exitrip/DEBAZAROS/ip_repo/edit_myip_v1_0.runs/synth_1/.vivado.begin.rst

<?xml version="1.0"?>
<ProcessHandle Version="1" Minor="0">
    <Process Command="vivado" Owner="aescape" Host="antmicro-debug" Pid="302607" HostCore="20" HostMemory="49028528">
    </Process>
</ProcessHandle>
