exitrip/DEBAZAROS/pcb/3xHDMI/3xHDMI-LCSC-BOM.csv

# | Reference | Value | Qty | SuppliersPartNumber
1 | C3,C7,C9 | 104n | 3 | C14663
2 | C4,C5 | 22p | 2 | C1653
3 | C6,C8 | 106n | 2 | C19702
4 | C10,C11,C12 | 103n | 3 | C57112
5 | D1 | SS34 | 1 | C8678
6 | D4 | LED | 1 | C84263
7 | J1 | HDMI0-OUT | 1 | C111617
9 | J3 | HDMI1-INOUT | 1 | C111617
10 | J4 | HDMI2-INOUT | 1 | C111617
11 | J5 | KH-TYPE-C-16P | 1 | C709357
12 | J6 | POWER_O | 1 | C49257
13 | J7 | DATA3 | 1 | C3012193
14 | J8 | DATA2 | 1 | C3012193
15 | J9 | DATA1 | 1 | C3012193
16 | J10 | SERIAL | 1 | C49257
17 | P1 | Header-Female-2.54_1x8 | 1 | C27438
18 | Q1,Q2,Q3,Q4,Q5,Q6,Q7,Q8,Q9 | AO3400 | 9 | C344010
19 | R1,R4,R7,R8,R9,R11,R15,R20,R23,R28,R31,R37,R38,R40,R43 | 10K | 15 | C25804
20 | R2,R3,R26 | 100K | 3 | C25803
21 | R5,R6,R27 | 27K | 3 | C22967
22 | R10,R12,R14,R16,R17,R21,R22,R24,R25,R29,R30,R32,R33,R39,R41,R42,R44,R45 | 2K2 | 18 | C4190
23 | R13,R18 | 5K1 | 2 | C23186
24 | R19 | 1K | 1 | C21190
25 | R34,R35,R36 | 1M | 3 | C22935
26 | RN1,RN2,RN3,RN4,RN5,RN6 | 49.9R | 6 | C54832
27 | SW1,SW2,SW3,SW4,SW5,SW6 | KEY | 6 | C318938
28 | U1 | CH340G | 1 | C14267
29 | U2 | AMS1117-3.3 | 1 | C347222
30 | X1 | 12MHz | 1 | C14871
