exitrip/DEBAZAROS/pcb/3xHDMI/3xHDMI-openEMS-TopyIn1-simple.FCStd

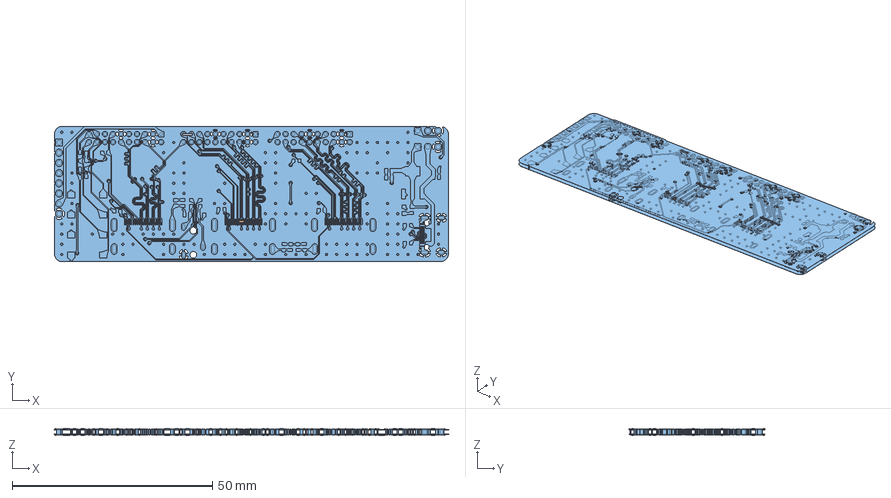
[picture p3: CAD file, 2026-08-24]
pcb/3xHDMI/3xHDMI-openEMS-TopyIn1-simple.FCStd
98.3 x 33.8 x 1.57 mm
portPin
portPout
copper
