exitrip/DEBAZAROS/pcb/3xHDMI/openEMS-sim/fr4_gen_model.stl

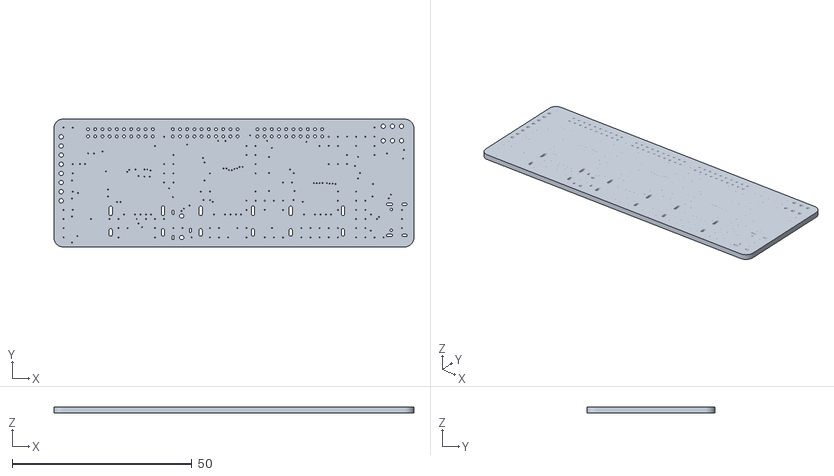
[picture p4: CAD file, 2026-08-24]
pcb/3xHDMI/openEMS-sim/fr4_gen_model.stl
100.0 x 35.5 x 1.59
