exitrip/DEBAZAROS/pcb/mech/enclosure.FCStd

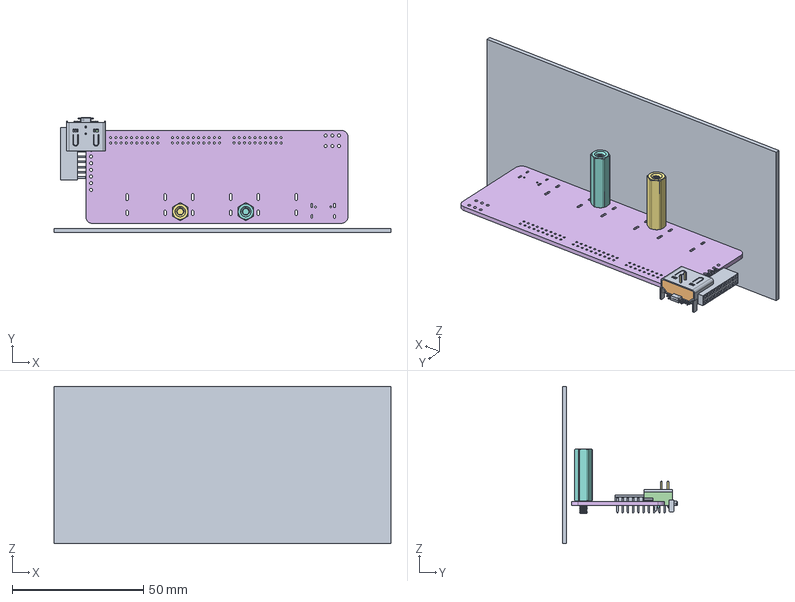
[picture p5: CAD file, 2026-11-03]
pcb/mech/enclosure.FCStd
128.5 x 44.0 x 60.0 mm
Panel
housing
contacts
R_0603_1608Metric
C_0603_1608Metric
R_0603_1608Metric002
R_0603_1608Metric004
PinSocket_2x10_P2.00mm_Horizontal
PinSocket_2x10_P2.00mm_Horizontal002
R_0603_1608Metric006
SOT-223
R_0603_1608Metric008
R_0603_1608Metric010
base
cover
actuator
leads
R_0603_1608Metric012
C_0603_1608Metric002
PinSocket_2x10_P2.00mm_Horizontal004
base001
cover001
actuator001
leads001
C_0603_1608Metric004
R_0603_1608Metric014
housing001
contacts001
R_0603_1608Metric016
R_0603_1608Metric018
housing002
contacts002
base002
cover002
actuator002
leads002
R_0603_1608Metric020
C_0603_1608Metric006
R_0603_1608Metric022
base003
cover003
actuator003
leads003
R_0603_1608Metric024
housing003
contacts003
LED_0603_1608Metric
C_0603_1608Metric008
R_0603_1608Metric026
R_0603_1608Metric028
C_0603_1608Metric010
R_0603_1608Metric030
SOIC-16_3.9x9.9mm_P1.27mm
SOT-23
SOT-226
R_Array_Convex_4x0603
R_0603_1608Metric032
R_0603_1608Metric034
PinHeader_1x02_P254mm_Vertical_SMD_Pin1Left
R_0603_1608Metric036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
