exitrip/DEBAZAROS/pcb/3xHDMI/openEMS-sim/air_gen_model.stl

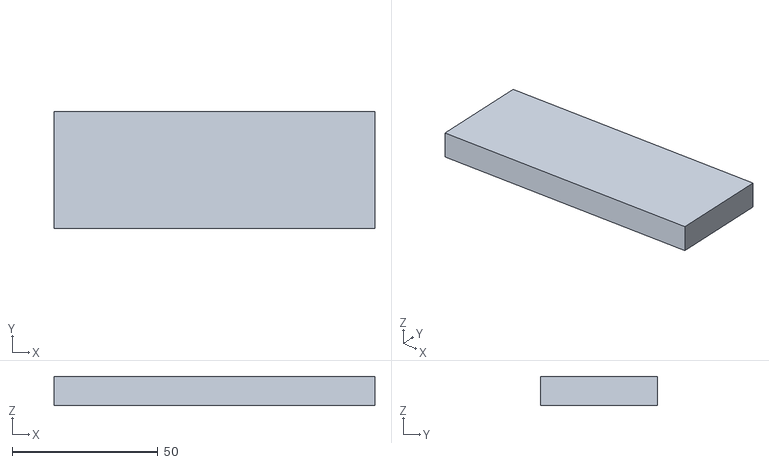
[picture p6: CAD file, 2026-08-24]
pcb/3xHDMI/openEMS-sim/air_gen_model.stl
110.0 x 40.0 x 10.0
