exitrip/DEBAZAROS/pcb/mech/3xHDMI.step

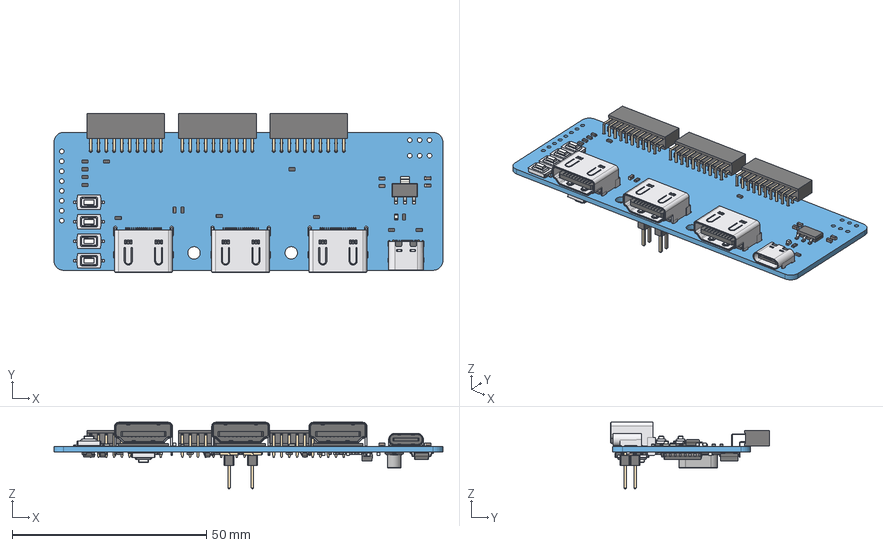
[picture p7: CAD file, 2026-11-01]
pcb/mech/3xHDMI.step
100.0 x 40.8 x 17.1 mm
housing x 4
contacts x 4
R_0603_1608Metric x 45
C_0603_1608Metric x 10
PinSocket_2x10_P2.00mm_Horizontal x 3
SOT-223
base x 6
cover x 6
actuator x 6
leads x 6
LED_0603_1608Metric
SOIC-16_3.9x9.9mm_P1.27mm
SOT-23 x 9
R_Array_Convex_4x0603 x 6
PinHeader_1x02_P254mm_Vertical_SMD_Pin1Left x 2
D_SMA
Crystal_SMD_HC49-SD
3xHDMI-unsaved-export-Y6YrKd_PCB
