exitrip/DEBAZAROS/pcb/mech/93655A428_Male-Female Threaded Hex Standoff.STEP

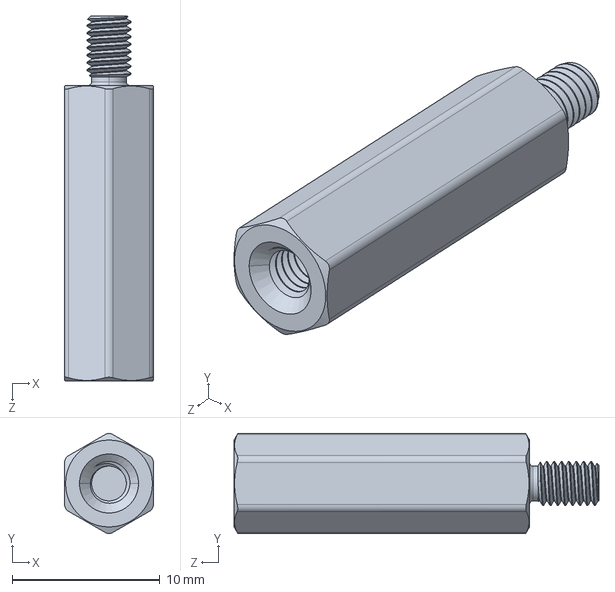
[picture p8: CAD file, 2026-11-01]
pcb/mech/93655A428_Male-Female Threaded Hex Standoff.STEP
6.00 x 6.77 x 24.7 mm
