exitrip/DEBAZAROS/pcb/3xHDMI/3xHDMI.kicad_pcb

## KiCad design pcb/3xHDMI/3xHDMI.kicad_pcb (2026-11-01)

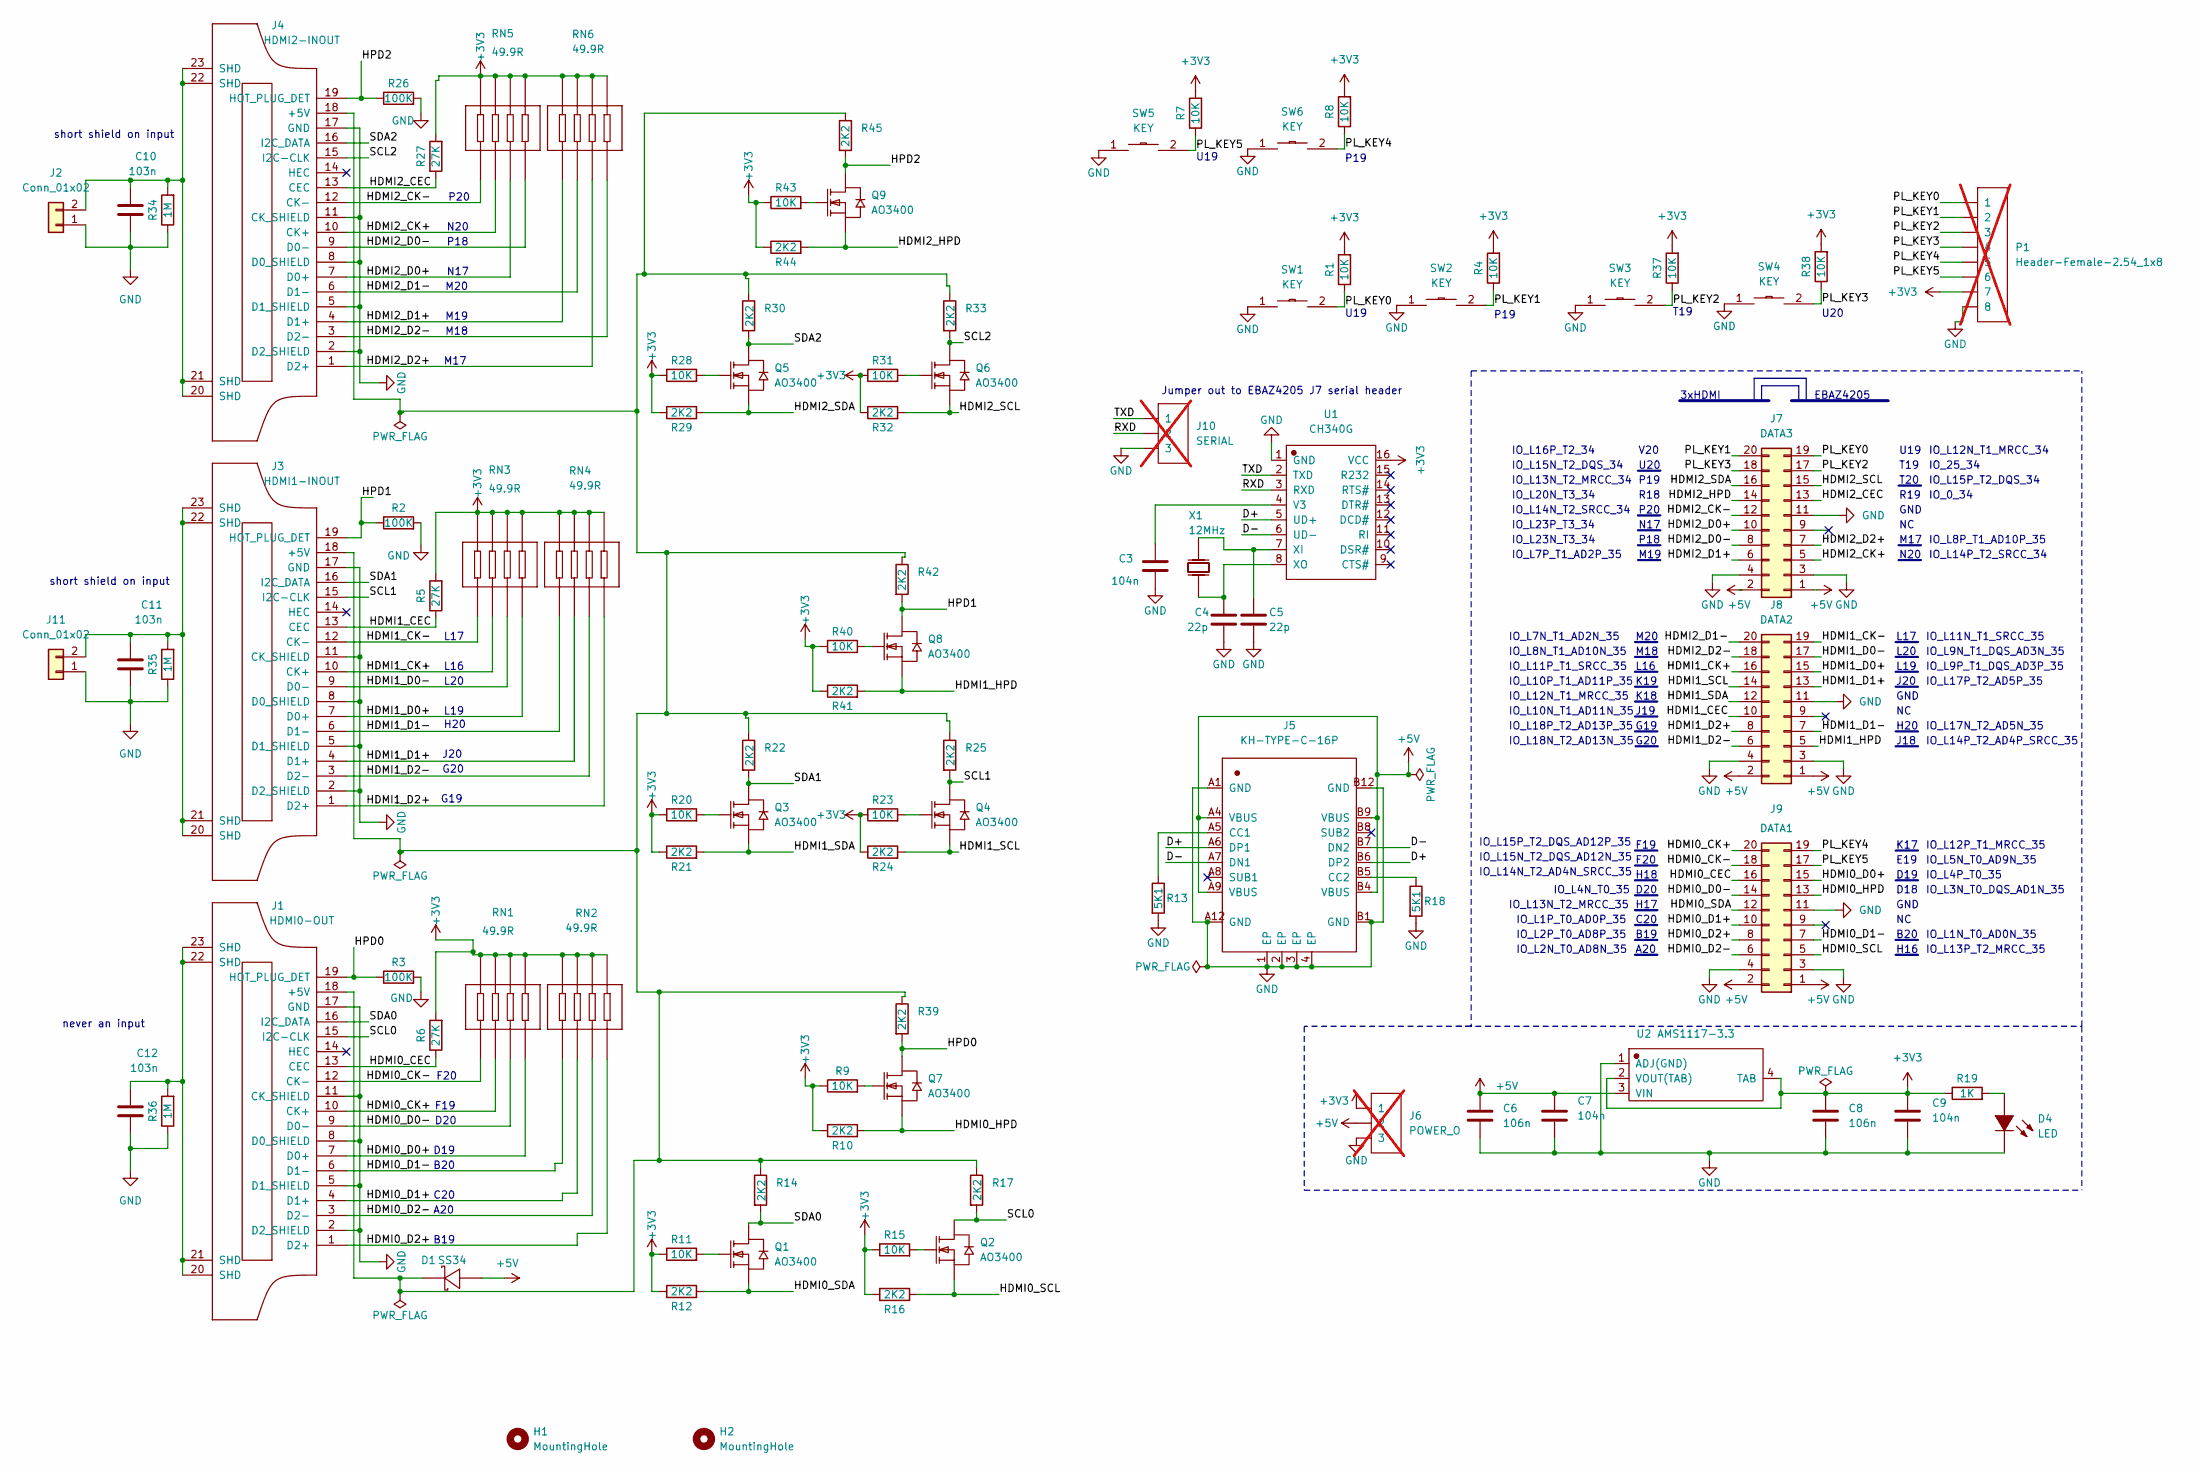
[picture p9: schematic 3xHDMI.kicad_sch]

Parts:
C3, C7, C9: 104n; C0603
C4, C5: 22p; C0603
C6, C8: 106n; C0603
C10, C11, C12: 103n; C0603
D1: SS34; DO-214AC_L4.3-W2.7-LS5.3-RD
D4: LED; LED0603-FD
H1, H2: MountingHole; MountingHole_3.2mm_M3
J1: HDMI0-OUT; HDMI-SMD_HDMI-019S
J2, J11: Conn_01x02; PinHeader_1x02_P2.54mm_Vertical_SMD_Pin1Left
J3: HDMI1-INOUT; HDMI-SMD_HDMI-019S
J4: HDMI2-INOUT; HDMI-SMD_HDMI-019S
J5: KH-TYPE-C-16P; USB-C-SMD_KH-TYPE-C-16P
J6: POWER_O; HDR-TH_3P-P2.54-V-M-1; not fitted
J7: DATA3; EBAZEXT-DAT
J8: DATA2; EBAZEXT-DAT
J9: DATA1; EBAZEXT-DAT
J10: SERIAL; HDR-TH_3P-P2.54-V-M-1; not fitted
P1: Header-Female-2.54_1x8; HDR-TH_8P-P2.54-V-F-1; not fitted
Q1, Q2, Q3, Q4, Q5, Q6, Q7, Q8, Q9: AO3400; SOT-23_L2.9-W1.3-P1.90-LS2.4-BR
R1, R4, R7, R8, R9, R11, R15, R20, R23, R28, R31, R37, R38, R40, R43: 10K; R0603
R2, R3, R26: 100K; R0603
R5, R6, R27: 27K; R0603
R10, R12, R14, R16, R17, R21, R22, R24, R25, R29, R30, R32, R33, R39, R41, R42, R44, R45: 2K2; R0603
R13, R18: 5K1; R0603
R19: 1K; R0603
R34, R35, R36: 1M; R0603
RN1, RN2, RN3, RN4, RN5, RN6: 49.9R; RES-ARRAY-SMD_0603-8P-L3.2-W1.6-BL
SW1, SW2, SW3, SW4, SW5, SW6: KEY; SW-SMD_L6.0-W3.3-LS8.0
U1: CH340G; SOIC-16_L9.9-W3.9-P1.27-LS6.0-BL
U2: AMS1117-3.3; SOT-223-4_L6.5-W3.5-P2.30-LS7.0-BR
X1: 12MHz; HC-49S_L11.4-W4.8

Connections:
+3V3: C8.1, C9.1, J6.1, P1.7, R1.2, R4.2, R5.2, R6.2, R7.2, R8.2, R9.1, R10.1, R11.1, R12.1, R15.1, R16.1, R19.1, R20.1, R21.1, R23.1, R24.1, R27.2, R28.1, R29.1, R31.1, R32.1, R37.2, R38.2, R40.1, R41.1, R43.1, R44.1, RN1.5, RN1.6, RN1.7, RN1.8, RN2.5, RN2.6, RN2.7, RN2.8, RN3.5, RN3.6, RN3.7, RN3.8, RN4.5, RN4.6, RN4.7, RN4.8, RN5.5, RN5.6, RN5.7, RN5.8, RN6.5, RN6.6, RN6.7, RN6.8, U1.16 (VCC), U2.2 (VOUT(TAB)), U2.4 (TAB)
+5V: C6.1, C7.1, D1.2 (A), J5.A4 (VBUS), J5.A9 (VBUS), J5.B4 (VBUS), J5.B9 (VBUS), J6.2, J7.1, J7.2, J8.1, J8.2, J9.1, J9.2, U2.3 (VIN)
/D+: J5.A6 (DP1), J5.B6 (DP2), U1.5 (UD+)
/D-: J5.A7 (DN1), J5.B7 (DN2), U1.6 (UD-)
/HDMI0_CEC: J1.13 (CEC), J9.16, R6.1
/HDMI0_CK+: J1.10 (CK+), J9.20, RN1.3
/HDMI0_CK-: J1.12 (CK-), J9.18, RN1.4
/HDMI0_D0+: J1.7 (D0+), J9.15, RN1.1
/HDMI0_D0-: J1.9 (D0-), J9.14, RN1.2
/HDMI0_D1+: J1.4 (D1+), J9.10, RN2.3
/HDMI0_D1-: J1.6 (D1-), J9.7, RN2.4
/HDMI0_D2+: J1.1 (D2+), J9.8, RN2.1
/HDMI0_D2-: J1.3 (D2-), J9.6, RN2.2
/HDMI0_HPD: J9.13, Q7.2 (S), R10.2
/HDMI0_SCL: J9.5, Q2.2 (S), R16.2
/HDMI0_SDA: J9.12, Q1.2 (S), R12.2
/HDMI1_CEC: J3.13 (CEC), J8.10, R5.1
/HDMI1_CK+: J3.10 (CK+), J8.16, RN3.2
/HDMI1_CK-: J3.12 (CK-), J8.19, RN3.1
/HDMI1_D0+: J3.7 (D0+), J8.15, RN3.4
/HDMI1_D0-: J3.9 (D0-), J8.17, RN3.3
/HDMI1_D1+: J3.4 (D1+), J8.13, RN4.2
/HDMI1_D1-: J3.6 (D1-), J8.7, RN4.1
/HDMI1_D2+: J3.1 (D2+), J8.8, RN4.4
/HDMI1_D2-: J3.3 (D2-), J8.6, RN4.3
/HDMI1_HPD: J8.5, Q8.2 (S), R41.2
/HDMI1_SCL: J8.14, Q4.2 (S), R24.2
/HDMI1_SDA: J8.12, Q3.2 (S), R21.2
/HDMI2_CEC: J4.13 (CEC), J7.13, R27.1
/HDMI2_CK+: J4.10 (CK+), J7.5, RN5.2
/HDMI2_CK-: J4.12 (CK-), J7.12, RN5.1
/HDMI2_D0+: J4.7 (D0+), J7.10, RN5.3
/HDMI2_D0-: J4.9 (D0-), J7.8, RN5.4
/HDMI2_D1+: J4.4 (D1+), J7.6, RN6.1
/HDMI2_D1-: J4.6 (D1-), J8.20, RN6.2
/HDMI2_D2+: J4.1 (D2+), J7.7, RN6.3
/HDMI2_D2-: J4.3 (D2-), J8.18, RN6.4
/HDMI2_HPD: J7.14, Q9.2 (S), R44.2
/HDMI2_SCL: J7.15, Q6.2 (S), R32.2
/HDMI2_SDA: J7.16, Q5.2 (S), R29.2
/HPD0: J1.19 (HOT_PLUG_DET), Q7.3 (D), R3.1, R39.2
/HPD1: J3.19 (HOT_PLUG_DET), Q8.3 (D), R2.1, R42.2
/HPD2: J4.19 (HOT_PLUG_DET), Q9.3 (D), R26.1, R45.2
/PL_KEY0: J7.19, P1.1, R1.1, SW1.2
/PL_KEY1: J7.20, P1.2, R4.1, SW2.2
/PL_KEY2: J7.17, P1.3, R37.1, SW3.2
/PL_KEY3: J7.18, P1.4, R38.1, SW4.2
/PL_KEY4: J9.19, P1.5, R8.1, SW6.2
/PL_KEY5: J9.17, P1.6, R7.1, SW5.2
/RXD: J10.2, U1.3 (RXD)
/SCL0: J1.15 (I2C-CLK), Q2.3 (D), R17.2
/SCL1: J3.15 (I2C-CLK), Q4.3 (D), R25.2
/SCL2: J4.15 (I2C-CLK), Q6.3 (D), R33.2
/SDA0: J1.16 (I2C_DATA), Q1.3 (D), R14.2
/SDA1: J3.16 (I2C_DATA), Q3.3 (D), R22.2
/SDA2: J4.16 (I2C_DATA), Q5.3 (D), R30.2
/TXD: J10.1, U1.2 (TXD)
GND: C3.2, C4.2, C5.2, C6.2, C7.2, C8.2, C9.2, C10.2, C11.2, C12.2, D4.2 (K), J1.2 (D2_SHIELD), J1.5 (D1_SHIELD), J1.8 (D0_SHIELD), J1.11 (CK_SHIELD), J1.17 (GND), J2.1, J3.2 (D2_SHIELD), J3.5 (D1_SHIELD), J3.8 (D0_SHIELD), J3.11 (CK_SHIELD), J3.17 (GND), J4.2 (D2_SHIELD), J4.5 (D1_SHIELD), J4.8 (D0_SHIELD), J4.11 (CK_SHIELD), J4.17 (GND), J5.1 (EP), J5.2 (EP), J5.3 (EP), J5.4 (EP), J5.A1 (GND), J5.A12 (GND), J5.B1 (GND), J5.B12 (GND), J6.3, J7.3, J7.4, J7.11, J8.3, J8.4, J8.11, J9.3, J9.4, J9.11, J10.3, J11.1, P1.8, R2.2, R3.2, R13.2, R18.2, R26.2, R34.1, R35.1, R36.1, SW1.1, SW2.1, SW3.1, SW4.1, SW5.1, SW6.1, U1.1 (GND), U2.1 (ADJ(GND))
unnamed: C12.1, J1.20 (SHD), J1.21 (SHD), J1.22 (SHD), J1.23 (SHD), R36.2
unnamed: D1.1 (K), J1.18 (+5V), J3.18 (+5V), J4.18 (+5V), R14.1, R17.1, R22.1, R25.1, R30.1, R33.1, R39.1, R42.1, R45.1
unnamed: D4.1 (A), R19.2
unnamed: C10.1, J2.2, J4.20 (SHD), J4.21 (SHD), J4.22 (SHD), J4.23 (SHD), R34.2
unnamed: J5.A5 (CC1), R13.1
unnamed: J5.B5 (CC2), R18.1
unnamed: C11.1, J3.20 (SHD), J3.21 (SHD), J3.22 (SHD), J3.23 (SHD), J11.2, R35.2
unnamed: Q1.1 (G), R11.2
unnamed: Q2.1 (G), R15.2
unnamed: Q3.1 (G), R20.2
unnamed: Q4.1 (G), R23.2
unnamed: Q5.1 (G), R28.2
unnamed: Q6.1 (G), R31.2
unnamed: Q7.1 (G), R9.2
unnamed: Q8.1 (G), R40.2
unnamed: Q9.1 (G), R43.2
unnamed: C3.1, U1.4 (V3)
unnamed: C5.1, U1.7 (XI), X1.1 (OSC1)
unnamed: C4.1, U1.8 (XO), X1.2 (OSC2)

Notes on the sheet:
IO_L3N_T0_DQS_AD1N_35
EBAZ4205
B19
M20
G20
L19
C20
IO_L11N_T1_SRCC_35
P19
GND
IO_L10P_T1_AD11P_35
IO_L5N_T0_AD9N_35
F20
IO_L9N_T1_DQS_AD3N_35
J18
K19
IO_L13P_T2_MRCC_35
R18
IO_L13N_T2_MRCC_35
A20
F19
IO_L9P_T1_DQS_AD3P_35
N20
IO_L1N_T0_AD0N_35
N17
L20
P20
G19
IO_L15P_T2_DQS_AD12P_35
D20
IO_L2P_T0_AD8P_35
IO_25_34
H20
short shield on input
IO_L23N_T3_34
3xHDMI
IO_L14N_T2_AD4N_SRCC_35
M18
H17
never an input
IO_L4P_T0_35
P18
U20
T19
IO_L7N_T1_AD2N_35
R19
IO_L14P_T2_AD4P_SRCC_35
IO_L11P_T1_SRCC_35
IO_L18P_T2_AD13P_35
IO_L15P_T2_DQS_34
IO_L20N_T3_34
J19
L16
IO_L8P_T1_AD10P_35
H16
IO_L1P_T0_AD0P_35
E19
IO_L12N_T1_MRCC_35
IO_L12N_T1_MRCC_34
IO_L4N_T0_35
IO_L12P_T1_MRCC_35
IO_L7P_T1_AD2P_35
IO_L15N_T2_DQS_AD12N_35
IO_L8N_T1_AD10N_35
U19
M17
B20
D18
IO_L16P_T2_34
IO_L2N_T0_AD8N_35
H18
IO_0_34
D19
IO_L14P_T2_SRCC_34
IO_L13N_T2_MRCC_34
IO_L10N_T1_AD11N_35
T20
IO_L18N_T2_AD13N_35
IO_L17N_T2_AD5N_35
M19
IO_L17P_T2_AD5P_35
IO_L15N_T2_DQS_34
Jumper out to EBAZ4205 J7 serial header
L17
J20
K18
IO_L23P_T3_34
V20
IO_L14N_T2_SRCC_34
K17

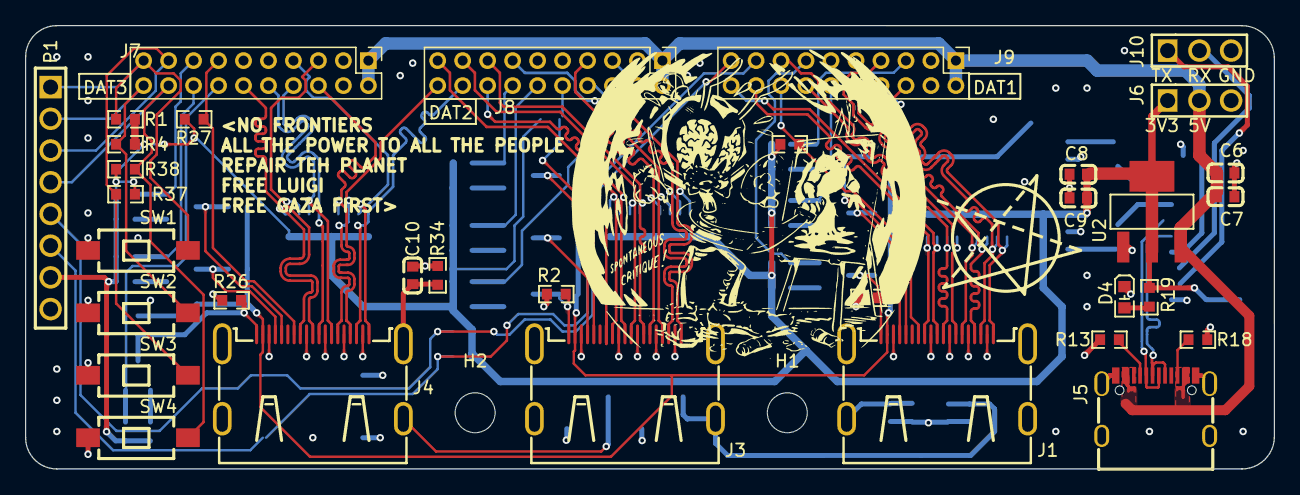
[picture p10: board 3xHDMI.kicad_pcb from above]

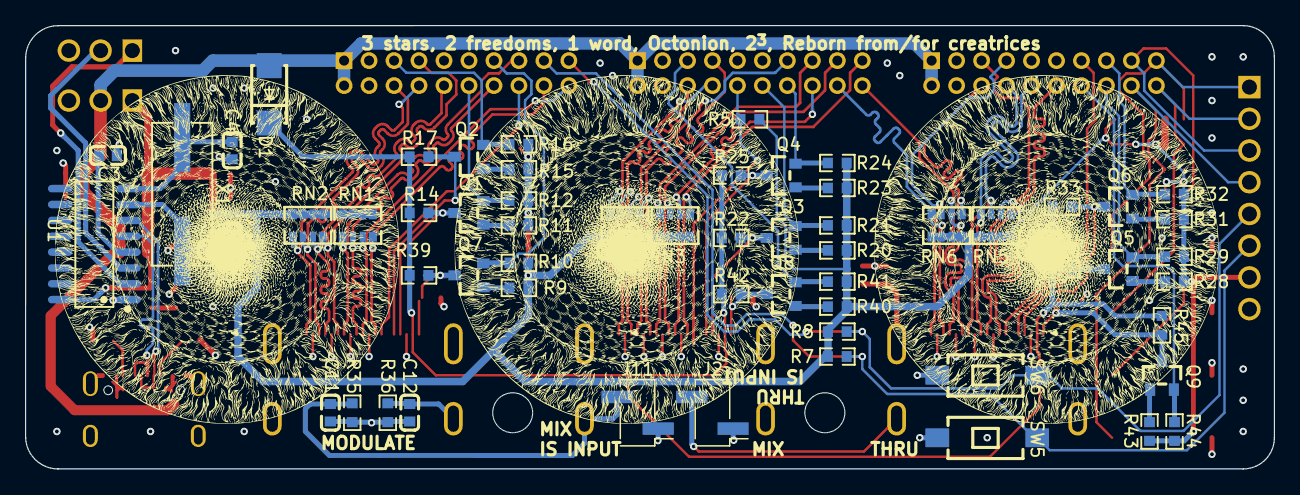
[picture p11: board 3xHDMI.kicad_pcb from below]

Board: 4 copper layers, 100.0 x 35.5 mm, 95 parts (59 on the bottom side), 77 nets.
