exitrip/DEBAZAROS/hw/xdc/ebaz4205.xdc

##
## @file        ebaz4205.xdc
## @brief       Xilinx Design Constraints for EBAZ4205
## @author      Keitetsu
## @date        2021/03/21
## @copyright   Copyright (c) 2021 Keitetsu
## @par         License
##              This software is released under the MIT License.
##

# Clock for Ethernet Transceiver
set_property IOSTANDARD LVCMOS33 [get_ports CLK25M]
set_property PACKAGE_PIN U18 [get_ports CLK25M]

# Ethernet Transceiver
set_property IOSTANDARD LVCMOS33 [get_ports ENET0_GMII_RX_CLK_0]
set_property IOSTANDARD LVCMOS33 [get_ports ENET0_GMII_TX_CLK_0]
set_property PACKAGE_PIN U14 [get_ports ENET0_GMII_RX_CLK_0]
set_property PACKAGE_PIN U15 [get_ports ENET0_GMII_TX_CLK_0]

#[Place 30-876] Port 'ENET0_GMII_TX_CLK_0'  is assigned to PACKAGE_PIN 'U15'  which can only be used as the N side of a differential clock input.
#Please use the following constraint(s) to pass this DRC check:
set_property CLOCK_DEDICATED_ROUTE FALSE [get_nets ENET0_GMII_TX_CLK_0_IBUF]

set_property IOSTANDARD LVCMOS33 [get_ports {enet0_gmii_rxd[3]}]
set_property IOSTANDARD LVCMOS33 [get_ports {enet0_gmii_rxd[2]}]
set_property IOSTANDARD LVCMOS33 [get_ports {enet0_gmii_rxd[1]}]
set_property IOSTANDARD LVCMOS33 [get_ports {enet0_gmii_rxd[0]}]
set_property IOSTANDARD LVCMOS33 [get_ports {ENET0_GMII_TX_EN_0[0]}]
set_property IOSTANDARD LVCMOS33 [get_ports {enet0_gmii_txd[3]}]
set_property IOSTANDARD LVCMOS33 [get_ports {enet0_gmii_txd[2]}]
set_property IOSTANDARD LVCMOS33 [get_ports {enet0_gmii_txd[1]}]
set_property IOSTANDARD LVCMOS33 [get_ports {enet0_gmii_txd[0]}]
set_property IOSTANDARD LVCMOS33 [get_ports ENET0_GMII_RX_DV_0]
set_property IOSTANDARD LVCMOS33 [get_ports MDIO_ETHERNET_0_0_mdc]
set_property IOSTANDARD LVCMOS33 [get_ports MDIO_ETHERNET_0_0_mdio_io]
set_property PACKAGE_PIN Y17 [get_ports {enet0_gmii_rxd[3]}]
set_property PACKAGE_PIN V17 [get_ports {enet0_gmii_rxd[2]}]
set_property PACKAGE_PIN V16 [get_ports {enet0_gmii_rxd[1]}]
set_property PACKAGE_PIN Y16 [get_ports {enet0_gmii_rxd[0]}]
set_property PACKAGE_PIN W19 [get_ports {ENET0_GMII_TX_EN_0[0]}]
set_property PACKAGE_PIN Y19 [get_ports {enet0_gmii_txd[3]}]
set_property PACKAGE_PIN V18 [get_ports {enet0_gmii_txd[2]}]
set_property PACKAGE_PIN Y18 [get_ports {enet0_gmii_txd[1]}]
set_property PACKAGE_PIN W18 [get_ports {enet0_gmii_txd[0]}]
set_property PACKAGE_PIN W16 [get_ports ENET0_GMII_RX_DV_0]
set_property PACKAGE_PIN W15 [get_ports MDIO_ETHERNET_0_0_mdc]
set_property PACKAGE_PIN Y14 [get_ports MDIO_ETHERNET_0_0_mdio_io]

# Green LED
set_property IOSTANDARD LVCMOS33 [get_ports {LED_GREEN[0]}]
set_property PACKAGE_PIN W13 [get_ports {LED_GREEN[0]}]

# Red LED
set_property IOSTANDARD LVCMOS33 [get_ports {LED_RED[0]}]
set_property PACKAGE_PIN W14 [get_ports {LED_RED[0]}]

#J3 4-pin fan connector: 12 V optocoupler level shift, NOT isolated (GND3 = GND via L36); ROADMAP.md section 11
set_property -dict {PACKAGE_PIN U12 IOSTANDARD LVCMOS33} [get_ports {J3P4_OUTPUT}]
set_property -dict {PACKAGE_PIN V13 IOSTANDARD LVCMOS33} [get_ports {J3P3_INPUT}]

#J5 4-pin fan connector: same circuit as J3
set_property -dict {PACKAGE_PIN V12 IOSTANDARD LVCMOS33} [get_ports {J5P4_OUTPUT}]
set_property -dict {PACKAGE_PIN V15 IOSTANDARD LVCMOS33} [get_ports {J5P3_INPUT}]

##MOD for LCDHaving extBoard
set_property -dict {PACKAGE_PIN A20 IOSTANDARD TMDS_33} [get_ports {TMDS_Data_n_0[2]}]
set_property -dict {PACKAGE_PIN F19 IOSTANDARD TMDS_33} [get_ports TMDS_Clk_p_0]
set_property -dict {PACKAGE_PIN B19 IOSTANDARD TMDS_33} [get_ports {TMDS_Data_p_0[2]}]
set_property -dict {PACKAGE_PIN B20 IOSTANDARD TMDS_33} [get_ports {TMDS_Data_n_0[1]}]
set_property -dict {PACKAGE_PIN C20 IOSTANDARD TMDS_33} [get_ports {TMDS_Data_p_0[1]}]
set_property -dict {PACKAGE_PIN F20 IOSTANDARD TMDS_33} [get_ports TMDS_Clk_n_0]
set_property -dict {PACKAGE_PIN D20 IOSTANDARD TMDS_33} [get_ports {TMDS_Data_n_0[0]}]
set_property -dict {PACKAGE_PIN D18 IOSTANDARD LVCMOS33} [get_ports {HDMI_HPD[0]}]
set_property -dict {PACKAGE_PIN H18 IOSTANDARD LVCMOS33} [get_ports HDMI_CEC_0]
set_property -dict {PACKAGE_PIN D19 IOSTANDARD TMDS_33} [get_ports {TMDS_Data_p_0[0]}]
#set_property -dict { PACKAGE_PIN H16   IOSTANDARD LVCMOS33 } [get_ports { HDMI_SCL_0 }];
#set_property -dict { PACKAGE_PIN H17   IOSTANDARD LVCMOS33 } [get_ports { HDMI_SDA_0 }];
set_property -dict { PACKAGE_PIN K17   IOSTANDARD LVCMOS33 } [get_ports { AUDIO_L }];
set_property -dict { PACKAGE_PIN E19   IOSTANDARD LVCMOS33 } [get_ports { AUDIO_R }];

##DATA2
#HDMI1
set_property -dict {PACKAGE_PIN L16 IOSTANDARD TMDS_33} [get_ports TMDS_Clk_p_1]
set_property -dict {PACKAGE_PIN L17 IOSTANDARD TMDS_33} [get_ports TMDS_Clk_n_1]
set_property -dict {PACKAGE_PIN G19 IOSTANDARD TMDS_33} [get_ports {TMDS_Data_p_1[2]}]
set_property -dict {PACKAGE_PIN G20 IOSTANDARD TMDS_33} [get_ports {TMDS_Data_n_1[2]}]
set_property -dict {PACKAGE_PIN J20 IOSTANDARD TMDS_33} [get_ports {TMDS_Data_p_1[1]}]
set_property -dict {PACKAGE_PIN H20 IOSTANDARD TMDS_33} [get_ports {TMDS_Data_n_1[1]}]
set_property -dict {PACKAGE_PIN L19 IOSTANDARD TMDS_33} [get_ports {TMDS_Data_p_1[0]}]
set_property -dict {PACKAGE_PIN L20 IOSTANDARD TMDS_33} [get_ports {TMDS_Data_n_1[0]}]
set_property -dict {PACKAGE_PIN J18 IOSTANDARD LVCMOS33} [get_ports {HDMI_HPD[1]}]
set_property -dict {PACKAGE_PIN J19 IOSTANDARD LVCMOS33} [get_ports {HDMI_CEC_1[0]}]
#set_property -dict { PACKAGE_PIN K19   IOSTANDARD LVCMOS33 } [get_ports { HDMI_SCL_1 }];
#set_property -dict { PACKAGE_PIN K18   IOSTANDARD LVCMOS33 } [get_ports { HDMI_SDA_1 }];

#HDMI2
#set_property -dict { PACKAGE_PIN M18   IOSTANDARD TMDS_33 } [get_ports {TMDS_Data_n_2[2]}];
#set_property -dict { PACKAGE_PIN M20   IOSTANDARD TMDS_33 } [get_ports {TMDS_Data_n_2[1]}];

#DATA3
#HDMI2
set_property -dict {PACKAGE_PIN N20 IOSTANDARD TMDS_33} [get_ports TMDS_Clk_p_2]
set_property -dict {PACKAGE_PIN P20 IOSTANDARD TMDS_33} [get_ports TMDS_Clk_n_2]
set_property -dict {PACKAGE_PIN M17 IOSTANDARD TMDS_33} [get_ports {TMDS_Data_p_2[2]}]
set_property -dict {PACKAGE_PIN M18 IOSTANDARD TMDS_33} [get_ports {TMDS_Data_n_2[2]}];
set_property -dict {PACKAGE_PIN M19 IOSTANDARD TMDS_33} [get_ports {TMDS_Data_p_2[1]}]
set_property -dict {PACKAGE_PIN M20 IOSTANDARD TMDS_33} [get_ports {TMDS_Data_n_2[1]}];
set_property -dict {PACKAGE_PIN N17 IOSTANDARD TMDS_33} [get_ports {TMDS_Data_p_2[0]}]
set_property -dict {PACKAGE_PIN P18 IOSTANDARD TMDS_33} [get_ports {TMDS_Data_n_2[0]}]
set_property -dict {PACKAGE_PIN R18 IOSTANDARD LVCMOS33} [get_ports HDMI_HPD_2]
#set_property -dict { PACKAGE_PIN R19   IOSTANDARD LVCMOS33 } [get_ports { HDMI_CEC_2[0] }];
set_property -dict {PACKAGE_PIN T20 IOSTANDARD LVCMOS33} [get_ports DDC_2_scl_io]
set_property -dict {PACKAGE_PIN P19 IOSTANDARD LVCMOS33} [get_ports DDC_2_sda_io]
##buttons
set_property -dict { PACKAGE_PIN U19   IOSTANDARD LVCMOS33 } [get_ports { PL_KEY[0] }];
set_property -dict { PACKAGE_PIN V20   IOSTANDARD LVCMOS33 } [get_ports { PL_KEY[1] }];
set_property -dict { PACKAGE_PIN T19   IOSTANDARD LVCMOS33 } [get_ports { PL_KEY[2] }];
set_property -dict { PACKAGE_PIN U20   IOSTANDARD LVCMOS33 } [get_ports { PL_KEY[3] }];

#720p60Hz max input
create_clock -period 13.468 -waveform {0.000 6.734} [get_ports TMDS_Clk_p_2]
#100T
create_clock -period 40.000 -name enet0_rx_clk [get_ports ENET0_GMII_RX_CLK_0]
create_clock -period 40.000 -name enet0_tx_clk [get_ports ENET0_GMII_TX_CLK_0]

#create_pblock pblock_AD9851
#add_cells_to_pblock [get_pblocks pblock_AD9851] [get_cells -quiet [list ebaz4205_i/AD9851]]
#resize_pblock [get_pblocks pblock_AD9851] -add {CLOCKREGION_X1Y0:CLOCKREGION_X1Y0}

create_pblock pblock_ebaz4205_i
add_cells_to_pblock [get_pblocks pblock_ebaz4205_i] [get_cells -quiet [list ebaz4205_i]]
resize_pblock [get_pblocks pblock_ebaz4205_i] -add {SLR0}

## HDMI audio (hw/rtl/hdmi_tx, 2026-10-26): clock-domain crossings by design.
## (gray pointers: Vivado merges the gray MSB into the binary MSB register, so
## the -from lists name both wg/wp and rg/rp)
## hdmi_rx: HDMI_2 input clock -> output pixel clock (gray-pointer FIFO),
## FCLK0 -> input clock (rx_ctrl synchronizers); hdmi_audio_regs samples the
## receiver's hold registers after a toggle handshake.
set_max_delay -datapath_only 5.0 -from [get_cells -quiet -hier -filter {NAME =~ *hdmi_rx_0/inst/wg_reg[*] || NAME =~ *hdmi_rx_0/inst/wp_reg[*]}] -to [get_cells -quiet -hier -filter {NAME =~ *hdmi_rx_0/inst/wg_s1_reg[*]}]
set_max_delay -datapath_only 5.0 -from [get_cells -quiet -hier -filter {NAME =~ *hdmi_rx_0/inst/rg_reg[*] || NAME =~ *hdmi_rx_0/inst/rp_reg[*]}] -to [get_cells -quiet -hier -filter {NAME =~ *hdmi_rx_0/inst/rg_s1_reg[*]}]
set_max_delay -datapath_only 10.0 -from [get_cells -quiet -hier -filter {NAME =~ *hdmi_rx_0/inst/fifo_reg*}] -to [get_cells -quiet -hier -filter {NAME =~ *hdmi_rx_0/inst/tx_aud_*_reg[*]}]
set_false_path -to [get_cells -quiet -hier -filter {NAME =~ *hdmi_rx_0/inst/clr_s_reg[0] || NAME =~ *hdmi_rx_0/inst/loop_s_reg[0]}]
set_false_path -to [get_cells -quiet -hier -filter {NAME =~ *hdmi_audio_regs_0/inst/pub_sync_reg[0]}]
set_max_delay -datapath_only 10.0 -from [get_cells -quiet -hier -filter {NAME =~ *hdmi_rx_0/inst/rx_*_reg*}] -to [get_cells -quiet -hier -filter {NAME =~ *hdmi_audio_regs_0/inst/*}]

## pl_io (hw/rtl/pl_io, 2026-10-27): two dz_async_fifo (HDMI_2 clock -> FCLK0
## for I2S out, FCLK0 -> HDMI_1 pixel clock for I2S in) + synchronizers
set_max_delay -datapath_only 5.0 -from [get_cells -quiet -hier -filter {NAME =~ *pl_io_0/* && (NAME =~ */wg_reg[*] || NAME =~ */wp_reg[*])}] -to [get_cells -quiet -hier -filter {NAME =~ *pl_io_0/* && NAME =~ */wg_s1_reg[*]}]
set_max_delay -datapath_only 5.0 -from [get_cells -quiet -hier -filter {NAME =~ *pl_io_0/* && (NAME =~ */rg_reg[*] || NAME =~ */rp_reg[*])}] -to [get_cells -quiet -hier -filter {NAME =~ *pl_io_0/* && NAME =~ */rg_s1_reg[*]}]
set_max_delay -datapath_only 10.0 -from [get_cells -quiet -hier -filter {NAME =~ *pl_io_0/* && NAME =~ */mem_reg*}]
set_false_path -to [get_cells -quiet -hier -filter {NAME =~ *pl_io_0/* && (NAME =~ */txsrc_s_reg[0] || NAME =~ */rxsrc_s_reg[0] || NAME =~ */in_s1_reg[*] || NAME =~ */din_s_reg[0])}]
## Linux PCM (2026-10-27): capture BRAM FIFO (HDMI_2 clock -> FCLK0, covered by
## the wg/wp, rg/rp and mem_reg lines above); one word per 48 kHz frame FCLK0 ->
## pixel clock (w0/w1 hold registers, stable for 20 us, toggle t0/t1).
## Vivado can put w0/w1 into the output register of the pf0/pf1 BRAM (build
## ev: "w0_reg/i_"), so the -from list also names those BRAMs.
set_false_path -to [get_cells -quiet -hier -filter {NAME =~ *pl_io_0/* && (NAME =~ */t0_s_reg[0] || NAME =~ */t1_s_reg[0] || NAME =~ */caprun_s_reg[0] || NAME =~ */pcmsel_s_reg[0] || NAME =~ */pcmsel0_s_reg[0])}]
set_max_delay -datapath_only 10.0 -from [get_cells -quiet -hier -filter {NAME =~ *pl_io_0/* && (NAME =~ */w0_reg[*] || NAME =~ */w1_reg[*] || NAME =~ */pf0/mem_reg* || NAME =~ */pf1/mem_reg*)}]
## events (hdmi_audio_regs page 1, 2026-10-27): vsync (pixel clock) and the
## fan pin 3 inputs into 2-FF synchronizers
set_false_path -to [get_cells -quiet -hier -filter {NAME =~ *hdmi_audio_regs_0/inst/ev_s1_reg[*]}]
## dz_regs bank 0 input (2026-10-29): gpio_in comes from several clocks (HDMI_2
## capture status, fid on FCLK2, user I/O pins) into a 2-FF synchronizer
set_false_path -to [get_cells -quiet -hier -filter {NAME =~ *dz_regs_0/inst/in_s1_reg[*]}]


## ---- output pixel clock (2026-10-28) ---------------------------------------
## axi_dynclk's MMCM is set at run time through the DRP (hdmi2 dynclk.c), so
## Vivado only sees the power-up setting: 500 MHz serial / 100 MHz pixel
## (10 ns). Timed for 108 MHz (1280x1024@60, 1280x960@60): serial 540 MHz =
## 100 MHz x 27 / 5, pixel = serial / 5 (BUFR) = 108 MHz = 9.259 ns.
## 1080p60 (148.5 MHz) stays selectable in hdmi2 but is NOT timed: its serial
## clock (742.5 MHz) is over the OSERDES limit of this speed grade (600 MHz),
## and its DDR load starves the displays (CLAUDE.md). It may glitch.
## (Build p148 timed 148.5 MHz: it could not close, and the placement spread.)
create_generated_clock -name dynclk_ser -source [get_pins ebaz4205_i/axi_dynclk_0/U0/Inst_mmcme2_drp/mmcm_adv_inst/CLKIN1] -multiply_by 27 -divide_by 5 [get_pins ebaz4205_i/axi_dynclk_0/U0/Inst_mmcme2_drp/mmcm_adv_inst/CLKOUT0]
## Global pixel clock (2026-11-02, ROADMAP.md task 20): MMCM CLKOUT1 (divide
## = 5 x CLKOUT0's) on a BUFG = PXL_CLK_O for all fabric logic, 108 MHz =
## 100 MHz x 27 / 25. The BUFR / 5 of the BUFIO serial clock (dynclk_ser /
## 5, derived by Vivado) now drives only the OSERDES CLKDIV; its phase
## against dynclk_pxl is one of 5 (the BUFR divider start): the TMDS words
## cross in hdmi_tx_cdc.v (gray pointers, LUTRAM), so the paths from
## dynclk_pxl to the BUFR clock are a CDC: datapath-only, under one period.
create_generated_clock -name dynclk_pxl -source [get_pins ebaz4205_i/axi_dynclk_0/U0/Inst_mmcme2_drp/mmcm_adv_inst/CLKIN1] -multiply_by 27 -divide_by 25 [get_pins ebaz4205_i/axi_dynclk_0/U0/Inst_mmcme2_drp/mmcm_adv_inst/CLKOUT1]
set dynclk_div [get_clocks -of_objects [get_pins -hier -filter {NAME =~ *axi_dynclk_0/U0/*BUFR_inst/O}]]
set_max_delay -datapath_only -from [get_clocks dynclk_pxl] -to $dynclk_div 9.0
set_max_delay -datapath_only -from $dynclk_div -to [get_clocks dynclk_pxl] 9.0
## The MMCM runs from FCLK0, but at run-time ratios FCLK0 and the pixel clock
## have no fixed phase: every crossing is a designed CDC or a quasi-static
## register (GPIO gains, mixer and VTC settings), and the HDMI_0 DDS quotient
## (FCLK0) into the mixer is a known untimed crossing (value glitches only).
set_clock_groups -asynchronous -group [get_clocks clk_fpga_0] -group [get_clocks -include_generated_clocks {dynclk_ser dynclk_pxl}]
## Mixer mode 1 and the colour matrix (coreRevision 26, 2026-11-02): systolic
## DSP48 MACs with their own registers (possible with the global pixel
## clock), timed for the 108 MHz above like everything else. (Until revision
## 25 mode 1 was combinational, ~17 ns, and false-pathed here.)

## fsync_gen (2026-10-28): VTC vsync (pixel clock) into a 2-FF synchronizer
## in FCLK2 (display VDMA frame sync)
set_false_path -to [get_cells -quiet -hier -filter {NAME =~ *fsync_gen_0/inst/vs_s_reg[0]}]
