exitrip/DEBAZAROS/hw/rtl/hdmi_tx/hdmi_tx.v

// hdmi_tx.v - DVI/HDMI transmitter with audio, a replacement for Digilent
// rgb2dvi 1.4 as this design uses it (kGenerateSerialClk = false,
// kRstActiveHigh = false, no lane swaps). BD module reference.
//
// ctrl = 0: DVI. The TMDS output is the same as rgb2dvi's (same encoder, same
//   channel mapping, same serializer); only the latency is LOOK + 3 clocks longer
//   (sync and data together, so the picture does not move).
// ctrl[0] = 1: HDMI. Data islands in the horizontal blanking of every line:
//   the AVI InfoFrame (every field), and with ctrl[1] audio in ONE format,
//   48 kHz 2-ch 16-bit L-PCM: Audio Clock Regeneration, Audio Sample packets
//   and the Audio InfoFrame. The island position comes from the incoming timing (VTC), so
//   any video mode works: the block measures the line length and the active
//   width, and a LOOK-pixel delay line finds the start of each active line
//   for the video preamble and guard band.
//
// ctrl bits (quasi-static, any clock):
//   [0]    HDMI mode (0 = DVI)
//   [1]    audio packets
//   [2]    test tone: 1 kHz square, -24 dBFS, on the internal sample clock
//   [9:8]  AVI VIC: 0 = 4 (720p60), 1 = 34 (1080p30), 2 = 16 (1080p60), 3 = none
//   [14:12] sync delay: DE, HSYNC and VSYNC N pixel clocks later (0..7). The
//          effects stages register the pixel data after v_axi4s_vid_out,
//          while the syncs come straight from it: without this the picture
//          is N px right of DE (the first N columns = blanking data, the last
//          N source columns lost). 2026-11-01, by eye on the board: HDMI_1
//          N = 5 (3 counted in the BD: colorGainFeedback1 + c_addsub_1/2;
//          the rest not traced), HDMI_0 no visible change at any N (0).
// fs_inc: internal 48 kHz sample clock, fs = fs_inc * f_pixel / 2^32 (0 = off;
//   720p60: 74.25 MHz -> fs_inc = 2776544).
// aud_l/aud_r/aud_valid: external samples, one strobe per stereo sample, in
//   the PixelClk domain (ignored while the test tone is on).
//
// Constant packets: hdmi_tx_rom.v, generated by gen_rom.py.
// Data islands, packets, ECC: ported from hdl-util/hdmi (c) 2019 Sameer Puri,
// MIT licence (LICENSE-hdl-util-MIT). Video encoder and serializer: same
// structure as Digilent rgb2dvi.
`timescale 1ns / 1ps
module hdmi_tx #(
    parameter LOOK = 10,           // >= 10: video preamble (8) + guard (2)
    // 2026-11-02 (ROADMAP.md task 20): 1 (default) = SerdesDivClk is the
    // BUFR / 5 of the BUFIO serial clock while PixelClk is the global BUFG
    // clock: the TMDS words cross in a FIFO (hdmi_tx_cdc.v). 0 = SerdesDivClk
    // has PixelClk's phase (axi_dynclk kSerialBufg true: BUFG + BUFG, or the
    // old design with one BUFR pixel clock): direct.
    parameter CDC_FIFO = 1
) (
    output wire       TMDS_Clk_p,
    output wire       TMDS_Clk_n,
    output wire [2:0] TMDS_Data_p,
    output wire [2:0] TMDS_Data_n,
    input  wire       aRst_n,
    input  wire [23:0] vid_pData,  // [23:16] R (ch 2), [15:8] B (ch 0), [7:0] G (ch 1)
    input  wire       vid_pVDE,
    input  wire       vid_pHSync,
    input  wire       vid_pVSync,
    input  wire       PixelClk,
    input  wire       SerialClk,
    input  wire       SerdesDivClk,  // the OSERDES CLKDIV (axi_dynclk PXL_CLK_DIV_O)
    input  wire [31:0] ctrl,
    input  wire [31:0] fs_inc,
    input  wire [15:0] aud_l,
    input  wire [15:0] aud_r,
    input  wire       aud_valid
);
    // ---- reset: asynchronous assert, synchronous release (as rgb2dvi) -----
    (* ASYNC_REG = "TRUE" *) reg [1:0] rst_sync = 2'b11;
    always @(posedge PixelClk or negedge aRst_n)
        if (!aRst_n)
            rst_sync <= 2'b11;
        else
            rst_sync <= {rst_sync[0], 1'b0};
    wire rst = rst_sync[1];

    reg [31:0] ctrl_q = 0;
    always @(posedge PixelClk) ctrl_q <= ctrl;
    wire       hdmi_en  = ctrl_q[0];
    wire       audio_en = ctrl_q[0] & ctrl_q[1];
    wire       tone_en  = ctrl_q[2];
    wire [1:0] avi_sel  = ctrl_q[9:8];
    wire [2:0] sync_dly = ctrl_q[14:12];

    // ---- sync delay (ctrl[14:12]): {DE, VSYNC, HSYNC} to the data latency ----
    reg  [2:0] sdl [0:6];
    integer j;
    always @(posedge PixelClk) begin
        sdl[0] <= {vid_pVDE, vid_pVSync, vid_pHSync};
        for (j = 1; j < 7; j = j + 1)
            sdl[j] <= sdl[j-1];
    end
    wire [2:0] sync_in = (sync_dly == 3'd0) ? {vid_pVDE, vid_pVSync, vid_pHSync} : sdl[sync_dly - 3'd1];
    wire       de_in   = sync_in[2];

    // ---- look-ahead delay line (SRLs) --------------------------------------
    reg [26:0] dly [0:LOOK-1];
    integer i;
    always @(posedge PixelClk) begin
        dly[0] <= {sync_in, vid_pData};
        for (i = 1; i < LOOK; i = i + 1)
            dly[i] <= dly[i-1];
    end
    wire [26:0] d = dly[LOOK-1];
    wire        de_d = d[26], vs_d = d[25], hs_d = d[24];
    wire [23:0] rgb_d = d[23:0];

    // clocks until the delayed DE rises (LOOK when the undelayed DE rises now)
    reg de_u_q = 0;
    reg [4:0] vcnt = 0;
    always @(posedge PixelClk) de_u_q <= de_in;
    wire rise_u = de_in & ~de_u_q;
    wire [4:0] kk = rise_u ? LOOK[4:0] : vcnt;
    always @(posedge PixelClk) vcnt <= (kk != 0) ? kk - 5'd1 : 5'd0;
    wire vid_pre_0   = hdmi_en && !de_d && kk >= 5'd3 && kk <= 5'd10;
    wire vid_guard_0 = hdmi_en && !de_d && (kk == 5'd1 || kk == 5'd2);

    // ---- line measurement on the delayed stream ----------------------------
    reg        de_d_q = 0;
    // lc: clocks since the last HSYNC rising edge (line length measurement:
    //     HSYNC is on every line, also in the vertical blanking; either sync
    //     polarity gives the same period)
    // hc: position in the line from the DE rise; wraps at line_len, so it
    //     also runs through the lines of the vertical blanking
    reg [12:0] lc = 0, hc = 0, line_len = 0, act_w = 0, llm1 = 0;
    reg        tvalid = 0, hs_d_q = 0;
    wire rise_d = de_d & ~de_d_q, fall_d = ~de_d & de_d_q;
    wire hs_rise = hs_d & ~hs_d_q;
    // llm1 = line_len - 1, one clock late after a change (tvalid needs two equal lines)
    wire [12:0] hc_n = rise_d ? 13'd0 : (hc == llm1) ? 13'd0 : hc + 13'd1;
    always @(posedge PixelClk) begin
        de_d_q <= de_d;
        hs_d_q <= hs_d;
        hc <= hc_n;
        llm1 <= line_len - 13'd1;
        lc <= hs_rise ? 13'd0 : (lc == 13'h1FFF) ? lc : lc + 13'd1;
        if (hs_rise) begin
            line_len <= lc + 13'd1;
            // valid after two equal lines in a row (mode changes, start-up)
            tvalid <= (lc + 13'd1 == line_len) && act_w != 0;
        end
        if (fall_d)
            act_w <= hc_n;
        if (rst) begin
            tvalid <= 1'b0;
            act_w <= 0;
        end
    end
    // packets per line: (blank - 30) / 32, max 18 (as hdl-util); blank and
    // npk are registers (they change at most once per line)
    reg  [12:0] blank = 0;
    reg  [4:0]  npk = 0;
    reg  [12:0] di_end = 0;
    always @(posedge PixelClk) begin
        blank <= line_len - act_w;
        npk <= (!tvalid || blank < 13'd62) ? 5'd0 :
               ((blank - 13'd30) >> 5) > 13'd18 ? 5'd18 : (blank - 13'd30) >> 5;
        di_end <= 13'd14 + {npk, 5'd0};
    end
    reg  vs_d_q = 0;
    always @(posedge PixelClk) vs_d_q <= vs_d;
    wire field_end = vs_d ^ vs_d_q;

    // ---- stage a: island position (2026-10-28, for 1080p60 = 6.73 ns) ---------
    // p = hc_n - act_w and the blank flag get their own clock; the window
    // compares follow in stage q. Data, syncs and the video preamble flags get
    // the same extra clock, so nothing moves.
    reg [12:0] p_a = 0;
    reg in_blank_a = 0, vid_pre_a = 0, vid_guard_a = 0, field_end_a = 0;
    reg de_a = 0, hs_a = 0, vs_a = 0;
    reg [23:0] rgb_a = 0;
    // hc_n >= act_w = no borrow out of hc_n - act_w: one carry chain for both
    wire [13:0] p_w = {1'b0, hc_n} - {1'b0, act_w};
    always @(posedge PixelClk) begin
        p_a <= p_w[12:0];
        in_blank_a <= !de_d && !p_w[13];
        vid_pre_a <= vid_pre_0;  vid_guard_a <= vid_guard_0;  field_end_a <= field_end;
        de_a <= de_d;  hs_a <= hs_d;  vs_a <= vs_d;  rgb_a <= rgb_d;
    end

    // data island: preamble p = 4..11, guard 12..13, packets 14.., guard 2
    wire di_on = hdmi_en && npk != 0 && in_blank_a;
    wire di_pre_0    = di_on && p_a >= 13'd4 && p_a < 13'd12;
    wire di_period_0 = di_on && p_a >= 13'd14 && p_a < di_end;
    wire di_guard_0  = di_on && ((p_a >= 13'd12 && p_a < 13'd14) || (p_a >= di_end && p_a < di_end + 13'd2));
    wire pkt_en = di_period_0 && (p_a[4:0] == 5'd14);   // (p - 14) mod 32 == 0

    // ---- stage q: register the scheduler decisions (2026-10-27) ----------------
    // The position compares (line length -> hc -> p -> island windows -> packet
    // start) reached the packet picker in one clock (12.6 ns). This stage cuts
    // it; data and syncs get the same extra clock, so nothing moves.
    reg vid_pre_q = 0, vid_guard_q = 0, di_pre_q = 0, di_guard_q = 0, di_period_q = 0;
    reg pkt_en_q = 0, field_end_q = 0, de_q = 0, hs_q = 0, vs_q = 0;
    reg [23:0] rgb_q = 0;
    always @(posedge PixelClk) begin
        vid_pre_q <= vid_pre_a;  vid_guard_q <= vid_guard_a;
        di_pre_q <= di_pre_0;    di_guard_q <= di_guard_0;  di_period_q <= di_period_0;
        pkt_en_q <= pkt_en;      field_end_q <= field_end_a;
        de_q <= de_a;  hs_q <= hs_a;  vs_q <= vs_a;  rgb_q <= rgb_a;
    end

    // ---- stage 1 -------------------------------------------------------------
    reg vid_pre_1 = 0, vid_guard_1 = 0, di_pre_1 = 0, di_guard_1 = 0, di_period_1 = 0;
    reg de_1 = 0, hs_1 = 0, vs_1 = 0;
    reg [23:0] rgb_1 = 0;
    always @(posedge PixelClk) begin
        vid_pre_1 <= vid_pre_q;  vid_guard_1 <= vid_guard_q;
        di_pre_1 <= di_pre_q;    di_guard_1 <= di_guard_q;  di_period_1 <= di_period_q;
        de_1 <= de_q;  hs_1 <= hs_q;  vs_1 <= vs_q;  rgb_1 <= rgb_q;
    end

    // ---- audio source ----------------------------------------------------------
    reg [31:0] nco = 0;
    reg        nco_tick = 0;
    always @(posedge PixelClk) {nco_tick, nco} <= {1'b0, nco} + {1'b0, fs_inc};
    reg [4:0]  tone_cnt = 0;
    reg        tone_hi = 0;
    always @(posedge PixelClk)
        if (nco_tick) begin
            tone_cnt <= (tone_cnt == 5'd23) ? 5'd0 : tone_cnt + 5'd1;
            if (tone_cnt == 5'd23) tone_hi <= ~tone_hi;
        end
    wire [15:0] tone = tone_hi ? 16'h0800 : 16'hF800;
    wire        smp_valid = tone_en ? nco_tick : aud_valid;
    wire [15:0] smp_l = tone_en ? tone : aud_l;
    wire [15:0] smp_r = tone_en ? tone : aud_r;

    // ---- packets ---------------------------------------------------------------
    wire [8:0]  packet_data;
    hdmi_tx_packets packets (
        .clk(PixelClk), .rst(rst), .audio_en(audio_en), .avi_sel(avi_sel),
        .field_end(field_end_q), .pkt_en(pkt_en_q), .period(di_period_1),
        .smp_valid(smp_valid), .smp_l(smp_l), .smp_r(smp_r),
        .packet_data(packet_data));

    // ---- stage 2: mode and per-channel inputs ---------------------------------
    reg [2:0]  mode = 0;
    reg [23:0] video = 0;
    reg [5:0]  cdata = 0;     // {ch2 {C1,C0}, ch1 {C1,C0}, ch0 {VSYNC,HSYNC}}
    reg [11:0] idata = 0;     // TERC4 nibbles {ch2, ch1, ch0}
    always @(posedge PixelClk) begin
        mode <= di_guard_1 ? 3'd4 : di_period_1 ? 3'd3 : vid_guard_1 ? 3'd2 : de_1 ? 3'd1 : 3'd0;
        video <= rgb_1;
        // preambles: CTL0 = 1 (ch1 C0); data island preamble also CTL2 = 1 (ch2 C0)
        cdata <= {1'b0, di_pre_1, 1'b0, vid_pre_1 | di_pre_1, vs_1, hs_1};
        // channel 0: [3] = 1 inside the island (as hdl-util), [2] header bit, sync
        idata <= {packet_data[8:5], packet_data[4:1], 1'b1, packet_data[0], vs_1, hs_1};
    end

    // ---- TMDS encoders (rgb2dvi mapping: ch2 R, ch1 [7:0], ch0 [15:8]) --------
    wire [9:0] tmds0, tmds1, tmds2;
    hdmi_tx_encoder #(.CN(0)) enc0 (.clk(PixelClk), .mode(mode), .video(video[15:8]),
        .ctrl(cdata[1:0]), .terc4(idata[3:0]), .tmds(tmds0));
    hdmi_tx_encoder #(.CN(1)) enc1 (.clk(PixelClk), .mode(mode), .video(video[7:0]),
        .ctrl(cdata[3:2]), .terc4(idata[7:4]), .tmds(tmds1));
    hdmi_tx_encoder #(.CN(2)) enc2 (.clk(PixelClk), .mode(mode), .video(video[23:16]),
        .ctrl(cdata[5:4]), .terc4(idata[11:8]), .tmds(tmds2));

    // ---- serializers ------------------------------------------------------------
    // the OSERDES run on SerdesDivClk (CLKDIV) with a reset synchronous to it
    wire [9:0] s0, s1, s2;
    wire       srst;
    generate
        if (CDC_FIFO) begin : g_cdc
            (* ASYNC_REG = "TRUE" *) reg [1:0] srst_sync = 2'b11;
            always @(posedge SerdesDivClk or negedge aRst_n)
                if (!aRst_n)
                    srst_sync <= 2'b11;
                else
                    srst_sync <= {srst_sync[0], 1'b0};
            assign srst = srst_sync[1];
            hdmi_tx_cdc #(.W(30)) cdc (.wclk(PixelClk), .wrst(rst), .wdata({tmds2, tmds1, tmds0}),
                .rclk(SerdesDivClk), .rrst(srst), .rdata({s2, s1, s0}));
        end else begin : g_direct
            assign srst = rst;
            assign {s2, s1, s0} = {tmds2, tmds1, tmds0};
        end
    endgenerate
    hdmi_tx_serdes ser_clk (.PixelClk(SerdesDivClk), .SerialClk(SerialClk), .rst(srst),
        .pdata(10'b1111100000), .out_p(TMDS_Clk_p), .out_n(TMDS_Clk_n));
    hdmi_tx_serdes ser_d0 (.PixelClk(SerdesDivClk), .SerialClk(SerialClk), .rst(srst),
        .pdata(s0), .out_p(TMDS_Data_p[0]), .out_n(TMDS_Data_n[0]));
    hdmi_tx_serdes ser_d1 (.PixelClk(SerdesDivClk), .SerialClk(SerialClk), .rst(srst),
        .pdata(s1), .out_p(TMDS_Data_p[1]), .out_n(TMDS_Data_n[1]));
    hdmi_tx_serdes ser_d2 (.PixelClk(SerdesDivClk), .SerialClk(SerialClk), .rst(srst),
        .pdata(s2), .out_p(TMDS_Data_p[2]), .out_n(TMDS_Data_n[2]));
endmodule
