exitrip/DEBAZAROS/sw/debazd/debazd.h

/*
 * debazd.h - internal interface between the debazd modules.
 */
#ifndef DEBAZD_H
#define DEBAZD_H

#include "dz_osc.h"
#include "dz_fields.h"

#include <netinet/in.h>

/* Reply to the sender of the message being handled. No-op for messages
 * that the daemon sends to itself (LFO templates, sequencers). */
void dzd_reply(const char *path, const char *tags, ...);
void dzd_reply_args(const char *path, const dz_arg *a, int n);	/* typed arguments */

/* Log line when debazd runs with -v. */
void dzd_log(const char *fmt, ...);

/* Handle one message as if it came from the network, without replies.
 * Used by LFO targets of the "message template" kind. */
void dzd_handle_internal(dz_msg *m);

/* ---- disp.c: frame stores, blank, sequencer, vsync thread ---- */
int  disp_init(int simulate);	/* starts the vsync thread */
void disp_close(void);
int  disp_dispatch(const dz_msg *m);	/* 0 = not a /disp or /vsync address */
int  disp_frame_fd(void);	/* eventfd: readable once per frame (or -1) */
int  disp_vsync_ok(void);	/* 1 while real vsync arrives */
double disp_frame_hz(void);	/* measured frame rate, 0 without vsync */
void disp_crop_reset(void);	/* crops back to 0 0 (video mode change) */
extern int capture_auto;	/* debazd.c: capture size follows the input */
extern int capture_plocked;	/* debazd.c: HDMI_2 input locked (1), not (0), not read yet (-1) */

void disp_anim_attach(int d, int on);	/* anim.c drives store 0 / gives it back */
void disp_anim_frame(void);		/* no vsync: one anim frame (main loop) */

/* ---- anim.c: image sequences out of a display (ROADMAP.md section 16) ---- */
int  anim_dispatch(const dz_msg *m);	/* 0 = not an /anim address */
void anim_tick(void);			/* once per frame (main loop) */
uint32_t anim_vsync(int d);		/* vsync thread, disp lock held: slot address
					 * to show now, 0 = no change */
int  anim_on(int d);
void anim_stop(int d);			/* main thread */
void anim_stop_all(void);
void anim_geometry(void);		/* video mode changed: fit again */
int  anim_folder_names(void (*cb)(const char *name, void *ctx), void *ctx);

/* ---- lfo.c: oscillators, wave shapers, step sequences ---- */
void lfo_init(void);
int  lfo_dispatch(const dz_msg *m);	/* 0 = not an /lfo address */
void lfo_tick(double dt);		/* once per frame (or timer) */
/* react.c: audio analysis (2026-11-01) */
int   react_dispatch(const dz_msg *m);	/* 0 = not an /audio/react address */
void  react_tick(void);			/* once per frame, before lfo_tick */
void  react_stop(void);
int   react_feature_index(const char *name);	/* -1 = unknown */
const char *react_feature_name(int i);
float react_feature(int i);		/* 0..1 (a full-scale sine = 1) */
int   react_samples(float *out, int n, int chan);	/* newest n capture samples (chan 0 =
					 * (L+R)/2, 1 = L, 2 = R), 0 = none */
int   react_spectrum(float *amp, int chan);	/* amplitudes [0..fft/2] of a channel
					 * (as react_samples), returns the bin count, 0 = none */
void  react_hold(int on, const char *why);	/* pause / resume the capture source */
int   react_capturing(void);		/* react's arecord holds the capture PCM */
void  dds_tick(void);			/* once per frame after react_tick: AWG scope */
/* Send a message template ("/addr a b $0 ...") to debazd itself. */
void dzd_send_template(const char *tpl);

/* ---- fx.c: colour matrix (hue, map) and colour key on the HDMI_0 mixer ---- */
int  fx_dispatch(const dz_msg *m);	/* 0 = not an /fx address */

/* ---- trans.c: timed field ramps (cue fades), /fx/xfade ---- */
int  trans_dispatch(const dz_msg *m);	/* 0 = not /fx/xfade or /trans/... */
void trans_tick(double dt);		/* once per frame, before lfo_tick */
/* ramp field f to raw target in secs (<= 0: at once); curve 0 linear, 1 smooth */
int  trans_field(const dz_field *f, uint32_t target, double secs, int curve);
void trans_stop_all(void);		/* every field ramp stops where it is */
void cue_tick(double dt);		/* once per frame: cue message ramps, dip */

/* ---- dds.c: dz_osc2 patterns, step table, AWG (fields: dz_fields.c) ---- */
int  ascii_dispatch(const dz_msg *m);	/* /ascii/<d>/... (ascii.c) */

/* ---- stats.c: /stats (debazd load, main-loop times, CPU, temperature) ---- */
int    stats_dispatch(const dz_msg *m);
double stats_now(void);			/* ms, monotonic */
void   stats_tick(double ms);		/* one frame tick took ms */
void   stats_osc(double ms);		/* one OSC packet took ms */
void   stats_pix(double ms);		/* one pixel-thread job or frame took ms */
void ascii_tick(void);			/* once per frame (pixel thread) */

/* ---- pix.c: the pixel thread (2026-11-03) ---- */
int  pix_init(void);
void pix_close(void);
int  pix_owns(const char *path);	/* 1 = an address of the pixel domain */
int  pix_here(void);			/* 1 = run pixel work inline (on the thread, or no thread) */
int  pix_post(const dz_msg *m, const struct sockaddr_in *from, int internal);
					/* 0, -1 = no thread (run inline), -2 = queue full */
void pix_frame(void);			/* main: once per frame (ASCII, movie ticks) */
void pix_monitor(void);			/* main: monitor interval (inline only without thread) */
void pix_sync(void);			/* main: wait until the messages posted so far ran */
void pix_lock(void);			/* main: no pixel job runs until pix_unlock */
void pix_unlock(void);
int  pix_queued(void);
/* debazd.c: run one message of the pixel domain with this reply context */
void dzd_pix_run(const uint8_t *msg, size_t len, const struct sockaddr_in *from, int internal);

/* ---- state model (state.c; ROADMAP.md section 15) ----
 * Every subsystem lists its targets: one OSC message of debazd each (the
 * message that sets it), under a key (normally the address; the DDS steps:
 * "/dds/<n>/step/<i>"). Dispatching the messages of a dump in its order
 * restores the state. Strings of a message are valid only during the call. */
typedef void (*state_cb)(const char *key, const dz_msg *m, void *ctx);
/* tags: i f s (s = const char *); key NULL = the address */
void st_emit(state_cb cb, void *ctx, const char *key, const char *path, const char *tags, ...);
void st_emit_args(state_cb cb, void *ctx, const char *key, const char *path,
		  const dz_arg *a, int n);
void state_dump(state_cb cb, void *ctx);
/* a list of targets: key + the OSC message bytes, in order */
typedef struct {
	char    *key;
	uint8_t *msg;
	size_t   len;
} st_tgt;
typedef struct {
	st_tgt *t;
	int     n, cap;
	int    *hix, hcap;		/* hash index of the keys (open addressing) */
} st_list;
void st_list_free(st_list *l);
int  st_list_find(const st_list *l, const char *key);	/* index or -1 */
int  st_list_put(st_list *l, const char *key, const uint8_t *msg, size_t len); /* replace or append */
int  st_list_put_msg(st_list *l, const char *key, const dz_msg *m);
void st_list_copy(st_list *dst, const st_list *src);
void st_list_dump(st_list *l);			/* the state now */
int  st_same(const st_list *a, int i, const st_list *b, int j);	/* equal message bytes */
void st_list_apply(const st_list *l);		/* dispatch in order (internal) */
/* the targets of `want` that differ from (or are missing in) `now` -> out */
void st_list_diff(const st_list *want, const st_list *now, st_list *out);
void st_reply_target(const char *path, const char *key, const dz_msg *m);
int  cue_dispatch(const dz_msg *m);	/* /show, /scene, /cue (cue.c) */
int  state_dispatch(const dz_msg *m);	/* /state, /state/snap|recall|diff */
void disp_state(state_cb cb, void *ctx);
void lfo_state(state_cb cb, void *ctx);
void react_state(state_cb cb, void *ctx);
void dds_state(state_cb cb, void *ctx);
void ascii_state(state_cb cb, void *ctx);
void sound_state(state_cb cb, void *ctx);	/* sources, file players */
void pwm_state(state_cb cb, void *ctx);	/* fan PWM (also the software one) */
void fx_state(state_cb cb, void *ctx);	/* /fx/wrap */
void audio_state(state_cb cb, void *ctx);	/* the automatic settings */
void anim_state(state_cb cb, void *ctx);	/* image sequences (anim.c) */
int  dds_dispatch(const dz_msg *m);	/* 0 = not a /dds pattern / table address */

/* ---- io.c: user I/O line functions by name ---- */
int  io_dispatch(const dz_msg *m);	/* 0 = not /io/pin or /io/pins */

/* ---- audio.c: 48 kHz rate setting from the video mode, HDMI_2 replug ---- */
int  audio_dispatch(const dz_msg *m);	/* 0 = not an /audio/fs or /capture/replug address */
void audio_tick(long ms);		/* from the monitor loop */
void audio_rx_hold(void);		/* no input rate replug for 10 s (video mode change) */
int  sound_dispatch(const dz_msg *m);	/* 0 = not /audio/play|stop|rec|status|out/<n>/source */
void sound_tick(void);			/* reaps finished players / recorder */
int  sound_playing(int out);		/* a file player runs on output out */
void sound_close(void);

/* ---- pwm.c: software PWM / servo pulses on the fan pin 4 outputs ---- */
void pwm_init(void);			/* starts the PWM thread */
void pwm_close(void);			/* stops it, optos off */
int  pwm_dispatch(const dz_msg *m);	/* 0 = not /fan/<n>/pwm|duty|servo, /fan/pwm/stats */

#endif /* DEBAZD_H */
