exitrip/DEBAZAROS/sw/debazd/dds.c

/*
 * dds.c - patterns and tables of the PL DDS engine dz_osc2 (build osc,
 * 2026-10-29; hw/rtl/dz_osc/dz_osc_ch.v, ROADMAP.md section 14).
 *
 * The registers of each channel are fields (dz_fields.c: /dds/<n>/shape,
 * /seq, /tick, ...). This file adds what a field cannot do: patterns that
 * set several registers from the running video mode, and the two
 * write-only tables (16 steps, 2048-entry AWG), of which it keeps a copy.
 *
 * Sizes are in the VISIBLE picture: "4 bars" = 4 cycles across the active
 * width. Line rate = measured frame rate x VTC GVSIZE, cycles per line =
 * cycles x GHSIZE / active width (the phase also runs in the blanking).
 * The phase runs on FCLK0 (100 MHz): an edge can move by ~0.75 px.
 *
 *   /dds/<n>/wave s:shape [f:hz]     free running (no reset, no sequencer)
 *   /dds/<n>/bars f:n [s:shape]      n vertical bars (phase reset at hsync)
 *   /dds/<n>/hbars f:n [s:shape]     n horizontal bands (LINESTEP, reset at vsync)
 *   /dds/<n>/checker i:cols i:rows [s:shape]   sequencer: 2 steps, tick hsync
 *   /dds/<n>/slant f:n f:shift       bars + shift cycles per line (diagonals)
 *   /dds/<n>/count f:n               the last bars / hbars / slant / checker
 *                                    again with n (bars, bands; checker: cols)
 *   /dds/<n>/cols i, /dds/<n>/rows i checker columns / rows alone
 *                                    (single values for LFO targets, e.g.
 *                                    "/dds/1/count $f0"; /dds/<n>/pattern ->
 *                                    s:name f:count i:rows f:shift s:shape)
 *   /dds/<n>/shift f:cycles          only LINESTEP: the diagonal, cycles per line
 *                                    (signed; an LFO can drive it: target
 *                                    "/dds/1/shift $f0")
 *   /dds/<n>/scroll f:speed          adds speed cycles per second (FRAMESTEP)
 *   /dds/<n>/pulse f:duty            pulse shape, high for duty (0..1) of a cycle
 *   /dds/<n>/off                     sequencer, reset, steps, offsets off (PINC stays)
 *   /dds/<n>/step i:idx i:start i:delta i:len [i:keep i:rst i:phase]
 *   /dds/<n>/step/<i> i:start i:delta i:len [i:keep i:rst i:phase]  (the
 *                                    same, one address per step: cues)
 *   /dds/<n>/steps                   -> /dds/<n>/step i*7 for steps 0..15, then
 *                                       /dds/<n>/steps/end
 *   /dds/<n>/awg s:"v v v ..."       2..1024 points 0..65535 (one cycle); linear
 *                                    interpolation to 2048 entries (cyclic)
 *   /dds/<n>/awg                     -> /dds/<n>/awg s:points (the copy)
 *   /dds/<n>/scope f:gain [s:mode] [s:sum|l|r] [s:wave|fft|fftlin]   audio scope
 *                                    (2026-11-01): each frame the react.c capture
 *                                    source goes into the AWG table.
 *                                    Sources: wave = the newest 2048 samples
 *                                    (0x8000 + sample x gain, clamped; default);
 *                                    fft = the spectrum of the channel, log
 *                                    frequency (47 Hz .. 24 kHz at fft 1024) and
 *                                    60 dB (20 log10(amp x gain) + 60) / 60:
 *                                    gain 1 = a full-scale sine at the top;
 *                                    fftlin = linear frequency, amp x gain.
 *                                    Modes: h = one cycle across the visible
 *                                    width (bars 1 awg: brightness along each
 *                                    line), v = one cycle down the frame (hbars
 *                                    1 awg), free = shape awg, free running: no
 *                                    phase reset, PINC stays (set /dds/<n>/hz),
 *                                    keep = the pattern stays (default h).
 *                                    gain 0 = off (the table keeps the last frame).
 *                                    sum = (L+R)/2 (default), l / r = one channel
 *   /dds/<n>/scope/gain f, /scope/mode s, /scope/channel s, /scope/source s
 *                                    one value alone (LFO targets, e.g.
 *                                    "/dds/1/scope/gain $f0")
 *   /dds/<n>/scope/skew f            the diagonal (2026-11-02): h = the cycle
 *                                    moves f cycles from the top to the bottom
 *                                    line (signed, LINESTEP); v = f cycles across
 *                                    the width (PINC; negative = the table read
 *                                    backwards). 0 = straight (default)
 *   /dds/<n>/scope/seam s:off|mirror|fade   the two ends of the table: mirror =
 *                                    the source compressed into the first half and
 *                                    mirrored, fade = the last 1/8 fades into the
 *                                    first entry. No jump where the cycle wraps
 *                                    (free running, h and v with skew)
 *   /dds/<n>/scope/trigger i:0|1     wave: start at a rising zero crossing (a
 *                                    still picture of a periodic sound)
 *   /dds/<n>/scope/smooth f          0..0.99: each entry = smooth x the last
 *                                    frame + (1 - smooth) x the new value
 *   /dds/<n>/scope/table             -> s: every 16th entry of the last table (128)
 *                                       (0..65535, before a backwards read)
 *   /dds/<n>/scope                   -> /dds/<n>/scope f:gain s:mode s:channel s:source
 *                                       f:skew s:seam i:trigger f:smooth
 *   /dds/raster                      -> /dds/raster f:line_hz f:frame_hz
 *                                       i:htotal i:vtotal i:width i:height
 * shape: sine saw sawdown tri square pulse awg, or 0..6.
 * The sine is two's complement; the other shapes are unsigned 0..0xFFFF
 * (do not set /dds/<n>/invert for them: a square becomes 0x8000 / 0x7FFF).
 */
#include "debazd.h"
#include "dz_hw.h"
#include "dz_map.h"
#include "dz_vdma.h"

#include <math.h>
#include <stdio.h>
#include <stdlib.h>
#include <string.h>

#ifdef HW_DZ_OSC2_0_BASE

#define R_PINC		0x00
#define R_CTRL		0x08
#define R_POFF		0x10
#define R_LSTEP		0x14
#define R_FSTEP		0x18
#define R_PWIDTH	0x1C
#define R_ID		0x28
#define R_STEP		0x100
#define R_AWG		0x2000
#define ID_DOSC		0x444F5343u
#define PINC_VALID	0x80000000u

#define C_SEQ		(1u << 0)
#define C_TICK(t)	((uint32_t)(t) << 1)
#define C_RESET(r)	((uint32_t)(r) << 4)
#define C_LAST(l)	((uint32_t)(l) << 8)
#define C_VSRESTART	(1u << 13)
#define C_SHAPE(s)	((uint32_t)(s) << 16)
#define TICK_HSYNC	1
#define RST_HSYNC	1
#define RST_VSYNC	2
#define SH_SQUARE	4
#define SH_PULSE	5

#define VTC_GHSIZE	0x070
#define VTC_GVSIZE	0x074

#define AWG_N		2048
#define PTS_MAX		1024

static const char *const shape_names[] = { "sine", "saw", "sawdown", "tri", "square", "pulse", "awg" };

static struct {
	uint32_t step[16][4];		/* START, DELTA, LEN|KEEP|RST, PHASE */
	uint16_t pts[PTS_MAX];		/* the AWG as it was sent */
	int      npts;
	int      wsteps;		/* debazd wrote the step table (else unknown) */
} ch[2];

/* the last pattern per channel, for the single-value setters */
enum { P_NONE, P_BARS, P_SLANT, P_HBARS, P_CHECKER };
static const char *const pat_names[] = { "none", "bars", "slant", "hbars", "checker" };
static struct {
	int    pat, rows, shape;
	double count, shift;
} P[2];

/* audio scope per channel */
static const char *const chan_names[] = { "sum", "l", "r" };
static const char *const src_names[] = { "wave", "fft", "fftlin" };
static const char *const seam_names[] = { "off", "mirror", "fade" };
static const char *const mode_names[] = { "h", "v", "free", "keep" };
enum { SM_H, SM_V, SM_FREE, SM_KEEP };
static struct {
	float gain;			/* 0 = off */
	int   mode;			/* SM_* */
	int   chan;			/* 0 sum, 1 L, 2 R (react_samples) */
	int   src;			/* 0 wave, 1 fft, 2 fftlin */
	int   seam, trig;
	float skew, smooth;
	float last[AWG_N];		/* for smooth */
} S[2];

static int name_arg(const char *c, const char *const *names, int n)
{
	for (int i = 0; i < n; i++)
		if (!strcmp(c, names[i]))
			return i;
	return -1;
}
#define NAMES(t) t, (int)(sizeof(t) / sizeof(t[0]))

static int chan_arg(const char *c)
{
	for (int i = 0; i < 3; i++)
		if (!strcmp(c, chan_names[i]))
			return i;
	return !strcmp(c, "L") ? 1 : !strcmp(c, "R") ? 2 : -1;
}


static uint32_t base_of(int n)
{
	return n ? HW_DDS_AXI_INTERFACE_1_BASE : HW_DDS_AXI_INTERFACE_0_BASE;
}

static void wr(int n, uint32_t off, uint32_t v)
{
	dz_wr(base_of(n), off, v);
}

/* dz_osc2 in the loaded bitstream (an older one has dds_axi_interface_0
 * there: reads 0 at +0x28; channel 1's address would be a bus error) */
static int present(void)
{
	return dz_regs_known(HW_DDS_AXI_INTERFACE_0_BASE) &&
	       dz_rd(HW_DDS_AXI_INTERFACE_0_BASE, R_ID) == ID_DOSC;
}

typedef struct {
	double line_hz, frame_hz;
	int    htotal, vtotal, w, h;
} raster;

static raster get_raster(void)
{
	raster r;

	r.htotal = (int)(dz_rd(HW_HDMI_0_V_TC_0_BASE, VTC_GHSIZE) & 0x1FFF);
	r.vtotal = (int)(dz_rd(HW_HDMI_0_V_TC_0_BASE, VTC_GVSIZE) & 0x1FFF);
	r.w = dz_geom_w();
	r.h = dz_geom_h();
	if (r.htotal < r.w || r.htotal <= 0)	/* VTC not readable: 720p */
		r.htotal = 1650;
	if (r.vtotal < r.h || r.vtotal <= 0)
		r.vtotal = 750;
	r.frame_hz = disp_frame_hz();
	if (r.frame_hz < 1.0)
		r.frame_hz = 60.0;
	r.line_hz = r.frame_hz * r.vtotal;
	return r;
}

/* phase increment for c cycles per second, clamped to 31 bits */
static uint32_t inc_hz(double c)
{
	double v = c * 4294967296.0 / DZ_DDS_CLK_HZ;

	if (v < 0)
		v = 0;
	if (v > 2147483647.0)
		v = 2147483647.0;
	return (uint32_t)llround(v);
}

/* 2^32 x frac, wrapped into one cycle (for offsets and steps) */
static uint32_t cycles32(double frac)
{
	double v = fmod(frac, 1.0);

	if (v < 0)
		v += 1.0;
	return (uint32_t)llround(v * 4294967296.0) ;
}

static double argf(const dz_arg *a)
{
	return a->type == 'f' ? (double)a->f : (double)a->i;
}

/* shape argument: a name or 0..6; def when absent; -1 = unknown */
static int arg_shape(const dz_msg *m, int i, int def)
{
	if (m->n <= i)
		return def;
	if (m->a[i].type == 's') {
		for (int s = 0; s < 7; s++)
			if (!strcmp(m->a[i].s, shape_names[s]))
				return s;
		if (!strcmp(m->a[i].s, "triangle"))
			return 3;
		return -1;
	}
	int s = (int)argf(&m->a[i]);
	return s >= 0 && s <= 6 ? s : -1;
}

static void clean(int n)
{
	wr(n, R_LSTEP, 0);
	wr(n, R_FSTEP, 0);
	wr(n, R_POFF, 0);
}

static void put_step(int n, int i, uint32_t start, uint32_t delta, uint32_t len, uint32_t ph)
{
	uint32_t *s = ch[n].step[i];

	s[0] = start;
	s[1] = delta;
	s[2] = len;
	s[3] = ph;
	ch[n].wsteps = 1;
	for (int k = 0; k < 4; k++)
		wr(n, R_STEP + 16u * (uint32_t)i + 4u * (uint32_t)k, s[k]);
}

static void reply_steps(int n)
{
	char p[24];

	snprintf(p, sizeof(p), "/dds/%d/step", n);
	for (int i = 0; i < 16; i++) {
		const uint32_t *s = ch[n].step[i];
		dzd_reply(p, "iiiiiii", i, (int)s[0], (int)s[1], (int)(s[2] & 0xFFFFFF),
			  (int)((s[2] >> 24) & 1), (int)((s[2] >> 25) & 1), (int)s[3]);
	}
	snprintf(p, sizeof(p), "/dds/%d/steps/end", n);
	dzd_reply(p, "");
}

/* points -> 2048 entries, linear, cyclic (the last point joins the first) */
static void write_awg(int n)
{
	const int np = ch[n].npts;

	for (int k = 0; k < AWG_N; k++) {
		double pos = (double)k * np / AWG_N;
		int    i = (int)pos;
		double fr = pos - i;
		double v = ch[n].pts[i] * (1.0 - fr) + ch[n].pts[(i + 1) % np] * fr;
		wr(n, R_AWG + 4u * (uint32_t)k, (uint32_t)lround(v) & 0xFFFF);
	}
}

static int set_awg(int n, const dz_msg *m)
{
	uint16_t pts[PTS_MAX];
	int np = 0;

	if (m->n == 1 && m->a[0].type == 's') {	/* "v v v", commas allowed */
		const char *s = m->a[0].s;
		char *e;
		while (*s && np < PTS_MAX) {
			while (*s == ' ' || *s == ',' || *s == '\t' || *s == '\n')
				s++;
			if (!*s)
				break;
			long v = strtol(s, &e, 0);
			if (e == s)
				return -1;
			pts[np++] = (uint16_t)(v < 0 ? 0 : v > 0xFFFF ? 0xFFFF : v);
			s = e;
		}
	} else {				/* up to 31 numbers as arguments */
		for (int i = 0; i < m->n && np < PTS_MAX; i++) {
			long v = (long)argf(&m->a[i]);
			pts[np++] = (uint16_t)(v < 0 ? 0 : v > 0xFFFF ? 0xFFFF : v);
		}
	}
	if (np < 2)
		return -1;
	memcpy(ch[n].pts, pts, sizeof(pts[0]) * (size_t)np);
	ch[n].npts = np;
	write_awg(n);
	return np;
}

static void reply_awg(int n)
{
	static char buf[PTS_MAX * 6 + 1];
	char p[24];
	size_t o = 0;

	for (int i = 0; i < ch[n].npts && o + 7 < sizeof(buf); i++)
		o += (size_t)snprintf(buf + o, sizeof(buf) - o, i ? " %u" : "%u", ch[n].pts[i]);
	buf[o] = 0;
	snprintf(p, sizeof(p), "/dds/%d/awg", n);
	dzd_reply(p, "s", buf);
}

/* write the pattern P[n] (bars, slant, hbars, checker) */
static void pattern(int n, raster r, double vis)
{
	int s = P[n].shape;

	clean(n);
	if (P[n].pat == P_BARS || P[n].pat == P_SLANT) {
		wr(n, R_PINC, PINC_VALID | inc_hz(P[n].count * vis * r.line_hz));
		if (P[n].pat == P_SLANT)
			wr(n, R_LSTEP, cycles32(P[n].shift));
		wr(n, R_CTRL, C_SHAPE(s) | C_RESET(RST_HSYNC));
	} else if (P[n].pat == P_HBARS) {
		wr(n, R_PINC, PINC_VALID);		/* increment 0: one value per line */
		wr(n, R_LSTEP, cycles32(P[n].count / (r.h > 0 ? r.h : 720)));
		wr(n, R_CTRL, C_SHAPE(s) | C_RESET(RST_VSYNC));
	} else if (P[n].pat == P_CHECKER) {
		int rows = P[n].rows;
		/* a square wave of cols/2 cycles: one cycle = a light and a dark column */
		uint32_t inc = inc_hz(P[n].count / 2.0 * vis * r.line_hz);
		uint32_t lines = (uint32_t)(r.h / rows > 0 ? r.h / rows : 1);

		put_step(n, 0, inc, 0, lines, 0);
		put_step(n, 1, inc, 0, lines, 0x80000000u);
		wr(n, R_PINC, PINC_VALID | inc);
		wr(n, R_CTRL, C_SEQ | C_TICK(TICK_HSYNC) | C_RESET(RST_HSYNC) | C_LAST(1) |
				  C_VSRESTART | C_SHAPE(s));
	}
}

/* the scope's pattern: one AWG cycle across the width (h) or down (v), with
 * the skew; free = shape awg without a reset (PINC stays) */
static void scope_pattern(int n, raster r, double vis)
{
	int hh = r.h > 0 ? r.h : 720;

	if (S[n].gain <= 0 || S[n].mode == SM_KEEP)
		return;
	P[n].count = 1;
	P[n].shape = 6;			/* awg */
	if (S[n].mode == SM_FREE) {
		P[n].pat = P_NONE;
		clean(n);
		wr(n, R_CTRL, C_SHAPE(6));
	} else if (S[n].mode == SM_H) {
		P[n].pat = S[n].skew != 0 ? P_SLANT : P_BARS;
		P[n].shift = S[n].skew / hh;
		pattern(n, r, vis);
	} else {
		/* v: acc runs |skew| x vis cycles per line, LINESTEP adds the rest of
		 * 1/h (dz_osc_ch.v: acc reset at vsync, line_off += LSTEP at hsync);
		 * a negative skew reads the table backwards (dds_tick) */
		double k = fabs(S[n].skew), dir = S[n].skew < 0 ? -1.0 : 1.0;

		P[n].pat = P_HBARS;
		P[n].shift = 0;
		clean(n);
		wr(n, R_PINC, PINC_VALID | inc_hz(k * vis * r.line_hz));
		wr(n, R_LSTEP, cycles32(dir / hh - k * vis));
		wr(n, R_CTRL, C_SHAPE(6) | C_RESET(RST_VSYNC));
	}
}

/* a new skew while the scope runs: only PINC / LINESTEP (no clean(): an LFO
 * may send it every frame) */
static void scope_skew(int n, raster r, double vis)
{
	int hh = r.h > 0 ? r.h : 720;

	if (S[n].mode == SM_H) {
		P[n].pat = S[n].skew != 0 ? P_SLANT : P_BARS;
		P[n].shift = S[n].skew / hh;
		wr(n, R_LSTEP, cycles32(P[n].shift));
	} else if (S[n].mode == SM_V) {
		double k = fabs(S[n].skew), dir = S[n].skew < 0 ? -1.0 : 1.0;

		wr(n, R_PINC, PINC_VALID | inc_hz(k * vis * r.line_hz));
		wr(n, R_LSTEP, cycles32(dir / hh - k * vis));
	}
}

int dds_dispatch(const dz_msg *m)
{
	const char *p = m->path, *c;
	int n;

	if (strncmp(p, "/dds/", 5))
		return 0;
	if (!strcmp(p, "/dds/raster")) {
		raster r = get_raster();
		dzd_reply("/dds/raster", "ffiiii", (float)r.line_hz, (float)r.frame_hz,
			  r.htotal, r.vtotal, r.w, r.h);
		return 1;
	}
	if ((p[5] != '0' && p[5] != '1') || p[6] != '/')
		return 0;
	n = p[5] - '0';
	c = p + 7;
	/* the commands of this file; anything else is a field */
	static const char *const cmds[] = { "wave", "bars", "hbars", "checker", "slant", "scroll",
					    "pulse", "off", "step", "steps", "awg", "shift",
					    "count", "cols", "rows", "pattern", "scope", "scope/gain",
					    "scope/mode", "scope/channel", "scope/source", "scope/skew",
					    "scope/seam", "scope/trigger", "scope/smooth", "scope/table" };
	int known = !strncmp(c, "step/", 5);	/* /dds/<n>/step/<i>: the state model */
	for (size_t i = 0; i < sizeof(cmds) / sizeof(cmds[0]); i++)
		if (!strcmp(c, cmds[i]))
			known = 1;
	if (!known)
		return 0;
	if (!present()) {
		dzd_reply("/error", "ss", p, "needs a bitstream with dz_osc2 (build osc or later)");
		return 1;
	}

	raster r = get_raster();
	double vis = (double)r.htotal / (r.w > 0 ? r.w : 1);	/* line / visible width */

	if (!strcmp(c, "wave")) {
		int s = arg_shape(m, 0, 0);
		if (s < 0)
			goto bad;
		clean(n);
		wr(n, R_CTRL, C_SHAPE(s));
		if (m->n >= 2)
			wr(n, R_PINC, PINC_VALID | inc_hz(argf(&m->a[1])));
	} else if (!strcmp(c, "bars") || !strcmp(c, "slant")) {
		int slant = c[0] == 's';
		if (m->n < 1 + slant)
			goto bad;
		int s = arg_shape(m, 1 + slant, SH_SQUARE);
		if (s < 0)
			goto bad;
		P[n].pat = slant ? P_SLANT : P_BARS;
		P[n].count = argf(&m->a[0]);
		P[n].shift = slant ? argf(&m->a[1]) : 0.0;
		P[n].shape = s;
		pattern(n, r, vis);
	} else if (!strcmp(c, "hbars")) {
		if (m->n < 1)
			goto bad;
		int s = arg_shape(m, 1, SH_SQUARE);
		if (s < 0)
			goto bad;
		P[n].pat = P_HBARS;
		P[n].count = argf(&m->a[0]);
		P[n].shape = s;
		pattern(n, r, vis);
	} else if (!strcmp(c, "checker")) {
		if (m->n < 2)
			goto bad;
		int cols = (int)argf(&m->a[0]), rows = (int)argf(&m->a[1]);
		int s = arg_shape(m, 2, SH_SQUARE);
		if (cols < 1 || rows < 1 || s < 0)
			goto bad;
		P[n].pat = P_CHECKER;
		P[n].count = cols;
		P[n].rows = rows;
		P[n].shape = s;
		pattern(n, r, vis);
	} else if (!strcmp(c, "count") || !strcmp(c, "cols") || !strcmp(c, "rows")) {
		if (m->n < 1 || P[n].pat == P_NONE)
			goto bad;		/* no pattern to change yet */
		double v = argf(&m->a[0]);
		if (c[0] == 'r') {
			if (P[n].pat != P_CHECKER || v < 1)
				goto bad;
			P[n].rows = (int)v;
		} else {
			if (P[n].pat == P_CHECKER && v < 1)
				goto bad;
			P[n].count = v;
		}
		pattern(n, r, vis);
	} else if (!strcmp(c, "pattern")) {
		dzd_reply(p, "sfifs", pat_names[P[n].pat], (float)P[n].count, P[n].rows,
			  (float)P[n].shift, shape_names[P[n].shape]);
		return 1;
	} else if (!strcmp(c, "shift")) {
		if (m->n < 1)
			goto bad;
		P[n].shift = argf(&m->a[0]);
		wr(n, R_LSTEP, cycles32(argf(&m->a[0])));
	} else if (!strcmp(c, "scroll")) {
		if (m->n < 1)
			goto bad;
		wr(n, R_FSTEP, cycles32(argf(&m->a[0]) / r.frame_hz));
	} else if (!strcmp(c, "pulse")) {
		if (m->n < 1)
			goto bad;
		double d = argf(&m->a[0]);
		d = d < 0 ? 0 : d > 1 ? 1 : d;
		wr(n, R_PWIDTH, d >= 1.0 ? 0xFFFFFFFFu : (uint32_t)llround(d * 4294967296.0));
		wr(n, R_CTRL, (dz_rd(base_of(n), R_CTRL) & ~C_SHAPE(7)) | C_SHAPE(SH_PULSE));
	} else if (!strcmp(c, "off")) {
		P[n].pat = P_NONE;
		wr(n, R_CTRL, 0);
		clean(n);
		for (int i = 0; i < 16; i++)
			put_step(n, i, 0, 0, 0, 0);
	} else if (!strncmp(c, "step/", 5)) {	/* start delta len [keep rst phase] */
		int i = atoi(c + 5);
		if (i < 0 || i > 15 || m->n < 3)
			goto bad;
		uint32_t len = (uint32_t)argf(&m->a[2]) & 0xFFFFFF;
		if (m->n > 3 && argf(&m->a[3]) != 0)
			len |= 1u << 24;
		if (m->n > 4 && argf(&m->a[4]) != 0)
			len |= 1u << 25;
		put_step(n, i, (uint32_t)(int64_t)argf(&m->a[0]), (uint32_t)(int64_t)argf(&m->a[1]), len,
			 m->n > 5 ? (uint32_t)(int64_t)argf(&m->a[5]) : 0);
	} else if (!strcmp(c, "step")) {
		if (m->n < 4)
			goto bad;
		int i = (int)argf(&m->a[0]);
		if (i < 0 || i > 15)
			goto bad;
		uint32_t len = (uint32_t)argf(&m->a[3]) & 0xFFFFFF;
		if (m->n > 4 && argf(&m->a[4]) != 0)
			len |= 1u << 24;		/* KEEP */
		if (m->n > 5 && argf(&m->a[5]) != 0)
			len |= 1u << 25;		/* RST */
		uint32_t ph = m->n > 6 ? (uint32_t)(int64_t)argf(&m->a[6]) : 0;
		put_step(n, i, (uint32_t)(int64_t)argf(&m->a[1]), (uint32_t)(int64_t)argf(&m->a[2]),
			 len, ph);
	} else if (!strcmp(c, "scope")) {
		if (m->n == 0) {
			dzd_reply(p, "fsssfsif", S[n].gain, mode_names[S[n].mode], chan_names[S[n].chan],
				  src_names[S[n].src], S[n].skew, seam_names[S[n].seam], S[n].trig,
				  S[n].smooth);
			return 1;
		}
		int md = m->n >= 2 && m->a[1].type == 's' ? name_arg(m->a[1].s, NAMES(mode_names)) : SM_H;
		int chn = m->n >= 3 && m->a[2].type == 's' ? chan_arg(m->a[2].s) : S[n].chan;
		int sr = m->n >= 4 && m->a[3].type == 's' ? name_arg(m->a[3].s, NAMES(src_names)) : S[n].src;
		if (md < 0 || chn < 0 || sr < 0)
			goto bad;
		int was_on = S[n].gain > 0, mode_new = md != S[n].mode;
		S[n].gain = (float)argf(&m->a[0]);
		S[n].chan = chn;
		S[n].src = sr;
		S[n].mode = md;
		if (!was_on || mode_new)
			scope_pattern(n, r, vis);
	} else if (!strcmp(c, "scope/gain")) {
		if (m->n < 1)
			goto bad;
		int was_on = S[n].gain > 0;
		S[n].gain = (float)argf(&m->a[0]);
		if (!was_on)			/* an LFO sends this every frame: pattern once */
			scope_pattern(n, r, vis);
	} else if (!strcmp(c, "scope/mode") || !strcmp(c, "scope/channel") ||
		   !strcmp(c, "scope/source") || !strcmp(c, "scope/seam")) {
		int v = -1;
		if (m->n >= 1 && m->a[0].type == 's') {
			if (c[6] == 'm')
				v = name_arg(m->a[0].s, NAMES(mode_names));
			else if (c[6] == 'c')
				v = chan_arg(m->a[0].s);
			else if (c[7] == 'o')
				v = name_arg(m->a[0].s, NAMES(src_names));
			else
				v = name_arg(m->a[0].s, NAMES(seam_names));
		}
		if (v < 0)
			goto bad;
		if (c[6] == 'm') {
			S[n].mode = v;
			scope_pattern(n, r, vis);
		} else if (c[6] == 'c') {
			S[n].chan = v;
		} else if (c[7] == 'o') {
			S[n].src = v;
		} else {
			S[n].seam = v;
		}
	} else if (!strcmp(c, "scope/skew")) {
		if (m->n < 1)
			goto bad;
		S[n].skew = (float)argf(&m->a[0]);
		if (S[n].gain > 0)		/* LFO-friendly: only the registers of the skew */
			scope_skew(n, r, vis);
	} else if (!strcmp(c, "scope/table")) {	/* every 16th entry of the last frame */
		char b[AWG_N / 16 * 6 + 1];
		size_t o = 0;
		for (int k = 0; k < AWG_N / 16; k++) {
			float v = S[n].last[16 * k] * 65535.0f;
			o += (size_t)snprintf(b + o, sizeof(b) - o, k ? " %d" : "%d",
					      v < 0 ? 0 : v > 65535 ? 65535 : (int)v);
		}
		dzd_reply(p, "s", b);
		return 1;
	} else if (!strcmp(c, "scope/trigger")) {
		if (m->n < 1)
			goto bad;
		S[n].trig = argf(&m->a[0]) != 0;
	} else if (!strcmp(c, "scope/smooth")) {
		if (m->n < 1)
			goto bad;
		double v = argf(&m->a[0]);
		S[n].smooth = (float)(v < 0 ? 0 : v > 0.99 ? 0.99 : v);
	} else if (!strcmp(c, "steps")) {
		reply_steps(n);
		return 1;
	} else if (!strcmp(c, "awg")) {
		if (m->n == 0) {
			reply_awg(n);
			return 1;
		}
		if (set_awg(n, m) < 0)
			goto bad;
	}
	dzd_reply(p, "i", 1);
	return 1;
bad:
	dzd_reply("/error", "ss", p, "bad arguments (see sw/debazd/dds.c)");
	return 1;
}

/* the newest 2048 samples, -1..1; with the trigger from the last rising zero
 * crossing that still leaves 2048 samples after it */
static int scope_wave(int n, float *t)
{
	static float buf[AWG_N * 2];
	int k0 = AWG_N;

	if (!S[n].trig)
		return react_samples(t, AWG_N, S[n].chan);
	if (!react_samples(buf, AWG_N * 2, S[n].chan))
		return 0;
	for (int k = AWG_N; k > 0; k--)		/* small hysteresis: no noise triggers */
		if (buf[k - 1] < 0 && buf[k] >= 0 && (k < 8 || buf[k - 8] < -0.002f)) {
			k0 = k;
			break;
		}
	memcpy(t, buf + k0, sizeof(float) * AWG_N);
	return AWG_N;
}

/* the spectrum on 2048 entries, 0..1: fft = log frequency (bin 1 .. the top)
 * and 60 dB; fftlin = linear frequency and amplitude */
static int scope_fft(int n, float *t)
{
	static float amp[1024 / 2 + 1], pos_t[2][AWG_N];
	static int pos_top[2];
	int nb = react_spectrum(amp, S[n].chan), top, lg = S[n].src == 1;
	float g = S[n].gain;

	if (nb < 3)
		return 0;
	top = nb - 1;
	if (pos_top[lg] != top) {		/* the bin of each entry (fft size changes) */
		for (int k = 0; k < AWG_N; k++)
			pos_t[lg][k] = (float)(lg ? pow((double)top, (double)k / (AWG_N - 1))
						  : 1.0 + (double)k * (top - 1) / (AWG_N - 1));
		pos_top[lg] = top;
	}
	for (int k = 0; k < AWG_N; k++) {
		float pos = pos_t[lg][k];
		int i = (int)pos;
		float fr = pos - (float)i, a = i >= top ? amp[top] : amp[i] * (1 - fr) + amp[i + 1] * fr;

		t[k] = lg ? (20.0f * log10f(a * g + 1e-9f) + 60.0f) * (1.0f / 60.0f) : a * g;
	}
	return AWG_N;
}

/* audio scope: the newest samples or the spectrum into the AWG table (2048
 * writes per channel and frame) */
void dds_tick(void)
{
	static float t[AWG_N], u[AWG_N];
	int ok = -1;

	for (int n = 0; n < 2; n++) {
		if (S[n].gain <= 0)
			continue;
		if (ok < 0)
			ok = present();
		if (!ok)
			return;
		if (S[n].src == 0) {
			if (!scope_wave(n, t))
				continue;
			for (int k = 0; k < AWG_N; k++)	/* 0..1, 0.5 = silence */
				t[k] = 0.5f + t[k] * S[n].gain * 0.5f;
		} else if (!scope_fft(n, t)) {
			continue;
		}
		if (S[n].seam == 1) {		/* first half: every 2nd entry, then mirrored */
			for (int k = 0; k < AWG_N / 2; k++)
				u[k] = u[AWG_N - 1 - k] = t[2 * k];
			memcpy(t, u, sizeof(t));
		} else if (S[n].seam == 2) {	/* the last 1/8 fades into the first entry */
			const int L = AWG_N / 8;

			for (int i = 0; i < L; i++) {
				float w = (float)(i + 1) / L;

				t[AWG_N - L + i] = t[AWG_N - L + i] * (1 - w) + t[0] * w;
			}
		}
		if (S[n].smooth > 0) {
			float a = S[n].smooth;

			for (int k = 0; k < AWG_N; k++)
				t[k] = S[n].last[k] = S[n].last[k] * a + t[k] * (1 - a);
		} else {
			memcpy(S[n].last, t, sizeof(t));
		}
		/* v with a negative skew reads the phase backwards (scope_pattern) */
		int back = S[n].mode == SM_V && S[n].skew < 0;
		for (int k = 0; k < AWG_N; k++) {
			float v = t[back ? (AWG_N - k) % AWG_N : k] * 65535.0f;

			v = v < 0 ? 0 : v > 65535 ? 65535 : v;
			wr(n, R_AWG + 4u * (uint32_t)k, (uint32_t)v);
		}
	}
}

/* the state model (state.c): the write-only tables, only if debazd wrote
 * them since it started (else the PL holds values nobody knows: left out) */
void dds_state(state_cb cb, void *ctx)
{
	static char pts[PTS_MAX * 6 + 1];
	char p[40], key[40];

	if (!present())
		return;
	for (int n = 0; n < 2; n++) {
		snprintf(p, sizeof(p), "/dds/%d/step", n);
		for (int i = 0; ch[n].wsteps && i < 16; i++) {
			const uint32_t *s = ch[n].step[i];

			snprintf(key, sizeof(key), "/dds/%d/step/%d", n, i);
			st_emit(cb, ctx, NULL, key, "iiiiii", (int)s[0], (int)s[1], (int)(s[2] & 0xFFFFFF),
				(int)((s[2] >> 24) & 1), (int)((s[2] >> 25) & 1), (int)s[3]);
		}
		if (ch[n].npts >= 2) {
			size_t l = 0;

			for (int k = 0; k < ch[n].npts; k++)
				l += (size_t)snprintf(pts + l, sizeof(pts) - l, "%s%u", k ? " " : "", ch[n].pts[k]);
			snprintf(p, sizeof(p), "/dds/%d/awg", n);
			st_emit(cb, ctx, NULL, p, "s", pts);
		}
		snprintf(p, sizeof(p), "/dds/%d/scope", n);
		st_emit(cb, ctx, NULL, p, "fsss", S[n].gain, mode_names[S[n].mode], chan_names[S[n].chan],
			src_names[S[n].src]);
		snprintf(p, sizeof(p), "/dds/%d/scope/skew", n);
		st_emit(cb, ctx, NULL, p, "f", S[n].skew);
		snprintf(p, sizeof(p), "/dds/%d/scope/seam", n);
		st_emit(cb, ctx, NULL, p, "s", seam_names[S[n].seam]);
		snprintf(p, sizeof(p), "/dds/%d/scope/trigger", n);
		st_emit(cb, ctx, NULL, p, "i", S[n].trig);
		snprintf(p, sizeof(p), "/dds/%d/scope/smooth", n);
		st_emit(cb, ctx, NULL, p, "f", S[n].smooth);
	}
}

#else	/* hw_map.h without dz_osc2 */

void dds_tick(void)
{
}

int dds_dispatch(const dz_msg *m)
{
	(void)m;
	return 0;
}

void dds_state(state_cb cb, void *ctx)
{
	(void)cb;
	(void)ctx;
}

#endif
