exitrip/DEBAZAROS/IP_axi_dynclk/src/axi_dynclk.vhd

library ieee;
use ieee.std_logic_1164.all;
use ieee.numeric_std.all;
use ieee.std_logic_unsigned.all;

library UNISIM;
use UNISIM.VComponents.all;


entity axi_dynclk is
   generic (
      -- Users to add parameters here
      kRefClkFreqHz : natural := 100_000_000;
      kVersionMajor : natural := 1;
      kVersionMinor : natural := 0;
      kAddBUFMR : boolean := false; --true, if BUFMR should be added between MMCM and BUFIO  
      -- DEBAZAROS 2026-11-02: false (default) = BUFIO + BUFR as before for
      -- the OSERDES (up to 120 MHz pixel by the OSERDES: keeps the 108 MHz
      -- modes in spec); the 1x of the BUFR has an unknown phase against the
      -- global PXL_CLK_O: hdmi_tx crosses with its FIFO (CDC_FIFO = 1).
      -- true = the serial clock (CLKOUT0, 5x) on a BUFG too: BUFG + BUFG
      -- (phase-aligned MMCM outputs, no FIFO), but BUFG max 464 MHz = 92.8
      -- MHz pixel in the -1 grade (hdmi_tx CDC_FIFO = 0).
      kSerialBufg : boolean := false;
      -- User parameters ends
      -- Do not modify the parameters beyond this line
   
   
      -- Parameters of Axi Slave Bus Interface S_AXI_LITE
      C_S_AXI_LITE_DATA_WIDTH   : integer   := 32;
      C_S_AXI_LITE_ADDR_WIDTH   : integer   := 6
   );
   port (
      -- Users to add ports here
		REF_CLK_I                     : in  std_logic;
      -- DEBAZAROS 2026-11-02 (ROADMAP.md task 20): PXL_CLK_O = MMCM CLKOUT1
      -- on a BUFG (global: all fabric logic of the pixel domain).
      -- PXL_CLK_5X_O + PXL_CLK_DIV_O = the OSERDES CLK + CLKDIV pair:
      -- kSerialBufg true: BUFG(CLKOUT0) + PXL_CLK_O; false: BUFIO + BUFR / 5
      -- (unknown phase against PXL_CLK_O: hdmi_tx_cdc.v FIFO).
      PXL_CLK_O                     : out std_logic;
      PXL_CLK_DIV_O                 : out std_logic;
      PXL_CLK_5X_O                  : out std_logic;
      LOCKED_O                      : out std_logic;   
      -- User ports ends
      -- Do not modify the ports beyond this line
   
   
      -- Ports of Axi Slave Bus Interface S_AXI_LITE
      s_axi_lite_aclk   : in std_logic;
      s_axi_lite_aresetn   : in std_logic;
      s_axi_lite_awaddr   : in std_logic_vector(C_S_AXI_LITE_ADDR_WIDTH-1 downto 0);
      s_axi_lite_awprot   : in std_logic_vector(2 downto 0);
      s_axi_lite_awvalid   : in std_logic;
      s_axi_lite_awready   : out std_logic;
      s_axi_lite_wdata   : in std_logic_vector(C_S_AXI_LITE_DATA_WIDTH-1 downto 0);
      s_axi_lite_wstrb   : in std_logic_vector((C_S_AXI_LITE_DATA_WIDTH/8)-1 downto 0);
      s_axi_lite_wvalid   : in std_logic;
      s_axi_lite_wready   : out std_logic;
      s_axi_lite_bresp   : out std_logic_vector(1 downto 0);
      s_axi_lite_bvalid   : out std_logic;
      s_axi_lite_bready   : in std_logic;
      s_axi_lite_araddr   : in std_logic_vector(C_S_AXI_LITE_ADDR_WIDTH-1 downto 0);
      s_axi_lite_arprot   : in std_logic_vector(2 downto 0);
      s_axi_lite_arvalid   : in std_logic;
      s_axi_lite_arready   : out std_logic;
      s_axi_lite_rdata   : out std_logic_vector(C_S_AXI_LITE_DATA_WIDTH-1 downto 0);
      s_axi_lite_rresp   : out std_logic_vector(1 downto 0);
      s_axi_lite_rvalid   : out std_logic;
      s_axi_lite_rready   : in std_logic
   );
end axi_dynclk;

architecture arch_imp of axi_dynclk is

	-- component declaration
	component axi_dynclk_S00_AXI is
		generic (
         kRefClkFreqHz : natural := 100_000_000;
         C_S_AXI_DATA_WIDTH	: integer	:= 32;
         C_S_AXI_ADDR_WIDTH	: integer	:= 6
		);
		port (
         CTRL_REG     :out std_logic_vector(C_S_AXI_DATA_WIDTH-1 downto 0);
         STAT_REG     :in  std_logic_vector(C_S_AXI_DATA_WIDTH-1 downto 0);
         CLK_O_REG    :out std_logic_vector(C_S_AXI_DATA_WIDTH-1 downto 0);
         CLK_FB_REG   :out std_logic_vector(C_S_AXI_DATA_WIDTH-1 downto 0);
         CLK_FRAC_REG :out std_logic_vector(C_S_AXI_DATA_WIDTH-1 downto 0);
         CLK_DIV_REG  :out std_logic_vector(C_S_AXI_DATA_WIDTH-1 downto 0);
         CLK_LOCK_REG :out std_logic_vector(C_S_AXI_DATA_WIDTH-1 downto 0);
         CLK_FLTR_REG :out std_logic_vector(C_S_AXI_DATA_WIDTH-1 downto 0);
         CLK_O1_REG   :out std_logic_vector(C_S_AXI_DATA_WIDTH-1 downto 0);
         S_AXI_ACLK	: in std_logic;
         S_AXI_ARESETN	: in std_logic;
         S_AXI_AWADDR	: in std_logic_vector(C_S_AXI_ADDR_WIDTH-1 downto 0);
         S_AXI_AWPROT	: in std_logic_vector(2 downto 0);
         S_AXI_AWVALID	: in std_logic;
         S_AXI_AWREADY	: out std_logic;
         S_AXI_WDATA	: in std_logic_vector(C_S_AXI_DATA_WIDTH-1 downto 0);
         S_AXI_WSTRB	: in std_logic_vector((C_S_AXI_DATA_WIDTH/8)-1 downto 0);
         S_AXI_WVALID	: in std_logic;
         S_AXI_WREADY	: out std_logic;
         S_AXI_BRESP	: out std_logic_vector(1 downto 0);
         S_AXI_BVALID	: out std_logic;
         S_AXI_BREADY	: in std_logic;
         S_AXI_ARADDR	: in std_logic_vector(C_S_AXI_ADDR_WIDTH-1 downto 0);
         S_AXI_ARPROT	: in std_logic_vector(2 downto 0);
         S_AXI_ARVALID	: in std_logic;
         S_AXI_ARREADY	: out std_logic;
         S_AXI_RDATA	: out std_logic_vector(C_S_AXI_DATA_WIDTH-1 downto 0);
         S_AXI_RRESP	: out std_logic_vector(1 downto 0);
         S_AXI_RVALID	: out std_logic;
         S_AXI_RREADY	: in std_logic
		);
	end component axi_dynclk_S00_AXI;
	
	
	component mmcme2_drp
	generic (
        DIV_F : integer
		);
	port(
		SEN               : in std_logic;
		SCLK              : in std_logic;
		RST               : in std_logic;
		S1_CLKOUT0        : in std_logic_vector(35 downto 0);
		S1_CLKOUT1        : in std_logic_vector(31 downto 0);
		S1_CLKFBOUT       : in std_logic_vector(35 downto 0);
		S1_DIVCLK         : in std_logic_vector(13 downto 0);
		S1_LOCK           : in std_logic_vector(39 downto 0);
		S1_DIGITAL_FILT   : in std_logic_vector(9 downto 0);
		REF_CLK           : in std_logic;
		CLKFBOUT_I		  : in std_logic;
		CLKFBOUT_O        : out std_logic;
		SRDY              : out std_logic;
		PXL_CLK           : out std_logic;
		PXL_CLK1          : out std_logic;
		LOCKED_O          : out std_logic
		);
	end component;
	
	
    signal CTRL_REG                       : std_logic_vector(C_S_AXI_LITE_DATA_WIDTH-1 downto 0);
    signal STAT_REG                       : std_logic_vector(C_S_AXI_LITE_DATA_WIDTH-1 downto 0);
    signal CLK_O_REG                      : std_logic_vector(C_S_AXI_LITE_DATA_WIDTH-1 downto 0);
    signal CLK_FB_REG                     : std_logic_vector(C_S_AXI_LITE_DATA_WIDTH-1 downto 0);
    signal CLK_FRAC_REG                   : std_logic_vector(C_S_AXI_LITE_DATA_WIDTH-1 downto 0);
    signal CLK_DIV_REG                    : std_logic_vector(C_S_AXI_LITE_DATA_WIDTH-1 downto 0);
    signal CLK_LOCK_REG                   : std_logic_vector(C_S_AXI_LITE_DATA_WIDTH-1 downto 0);
    signal CLK_FLTR_REG                   : std_logic_vector(C_S_AXI_LITE_DATA_WIDTH-1 downto 0);
    signal CLK_O1_REG                     : std_logic_vector(C_S_AXI_LITE_DATA_WIDTH-1 downto 0);

	type CLK_STATE_TYPE is (RESET, WAIT_LOCKED, WAIT_EN, WAIT_SRDY, ENABLED);
	signal clk_state                 : CLK_STATE_TYPE := RESET;
	signal srdy                      : std_logic;
	signal pxl_clk                   : std_logic;
	signal aLocked, xLocked, xBUFR_Rst : std_logic;
   signal xLckdFallingFlag, xLckdRisingFlag : std_logic;
   signal xLocked_q : std_logic_vector(1 downto 0);	
	signal sen_reg                   : std_logic := '0';
 
	signal mmcm_fbclk_in             : std_logic;
	signal mmcm_fbclk_out            : std_logic;
	signal mmcm_clk					 : std_logic;
	signal mmcm_clk1				 : std_logic;
	signal pxl_clk_g				 : std_logic;
	
	signal bufio_in                 : std_logic;
begin

-- Instantiation of Axi Bus Interface S00_AXI
axi_dynclk_S00_AXI_inst : axi_dynclk_S00_AXI
	generic map (
      kRefClkFreqHz         => kRefClkFreqHz,
      C_S_AXI_DATA_WIDTH	=> C_S_AXI_LITE_DATA_WIDTH,
      C_S_AXI_ADDR_WIDTH	=> C_S_AXI_LITE_ADDR_WIDTH
	)
	port map (
      CTRL_REG     => CTRL_REG,    
      STAT_REG     => STAT_REG,   
      CLK_O_REG    => CLK_O_REG,    
      CLK_FB_REG   => CLK_FB_REG,
      CLK_FRAC_REG => CLK_FRAC_REG, 
      CLK_DIV_REG  => CLK_DIV_REG,  
      CLK_LOCK_REG => CLK_LOCK_REG,
      CLK_FLTR_REG => CLK_FLTR_REG,
      CLK_O1_REG   => CLK_O1_REG,
		
      S_AXI_ACLK	=> s_axi_lite_aclk,
      S_AXI_ARESETN   => s_axi_lite_aresetn,
      S_AXI_AWADDR   => s_axi_lite_awaddr,
      S_AXI_AWPROT   => s_axi_lite_awprot,
      S_AXI_AWVALID   => s_axi_lite_awvalid,
      S_AXI_AWREADY   => s_axi_lite_awready,
      S_AXI_WDATA   => s_axi_lite_wdata,
      S_AXI_WSTRB   => s_axi_lite_wstrb,
      S_AXI_WVALID   => s_axi_lite_wvalid,
      S_AXI_WREADY   => s_axi_lite_wready,
      S_AXI_BRESP   => s_axi_lite_bresp,
      S_AXI_BVALID   => s_axi_lite_bvalid,
      S_AXI_BREADY   => s_axi_lite_bready,
      S_AXI_ARADDR   => s_axi_lite_araddr,
      S_AXI_ARPROT   => s_axi_lite_arprot,
      S_AXI_ARVALID   => s_axi_lite_arvalid,
      S_AXI_ARREADY   => s_axi_lite_arready,
      S_AXI_RDATA   => s_axi_lite_rdata,
      S_AXI_RRESP   => s_axi_lite_rresp,
      S_AXI_RVALID   => s_axi_lite_rvalid,
      S_AXI_RREADY   => s_axi_lite_rready
   );

GenerateBUFMR: if kAddBUFMR generate
BUFMR_inst : BUFMR
   port map (
      O => bufio_in, -- 1-bit output: Clock output (connect to BUFIOs/BUFRs)
      I => mmcm_clk  -- 1-bit input: Clock input (Connect to IBUF)
   );
end generate GenerateBUFMR;

DontGenerateBUFMR: if not kAddBUFMR generate
    bufio_in <= mmcm_clk;
end generate DontGenerateBUFMR;

	-- Add user logic here
RegionalSerial: if not kSerialBufg generate
	BUFIO_inst : BUFIO
	port map (
		O => PXL_CLK_5X_O, -- 1-bit output: Clock output (connect to I/O clock loads).
		I => bufio_in  -- 1-bit input: Clock input (connect to an IBUF or BUFMR).
	);

	BUFR_inst : BUFR
	generic map (
		BUFR_DIVIDE => "5",   -- Values: "BYPASS, 1, 2, 3, 4, 5, 6, 7, 8" 
		SIM_DEVICE => "7SERIES"  -- Must be set to "7SERIES" 
	)
	port map (
		O => pxl_clk,     -- 1-bit output: Clock output port
		CE => '1',   -- 1-bit input: Active high, clock enable (Divided modes only)
		CLR => xBUFR_Rst, -- 1-bit input: Active high, asynchronous clear (Divided modes only)		
		I => bufio_in      -- 1-bit input: Clock buffer input driven by an IBUF, MMCM or local interconnect
	);
end generate RegionalSerial;

GlobalSerial: if kSerialBufg generate
	BUFG_ser : BUFG
	port map (
		O => PXL_CLK_5X_O,
		I => mmcm_clk
	);
	pxl_clk <= pxl_clk_g;		-- CLKDIV = the global pixel clock itself
end generate GlobalSerial;
   
xBUFR_Rst <= xLckdRisingFlag; --pulse CLR on BUFR once the clock returns
  
  Inst_mmcme2_drp: mmcme2_drp 
  GENERIC MAP(
  DIV_F => 2
  )  
  PORT MAP(
		SEN => sen_reg,
		SCLK => s_axi_lite_aclk,
		RST => not(s_axi_lite_aresetn),
		SRDY => srdy,
		S1_CLKOUT0 => CLK_FRAC_REG(3 downto 0) & CLK_O_REG,
		S1_CLKOUT1 => CLK_O1_REG,
		S1_CLKFBOUT => CLK_FRAC_REG(19 downto 16) & CLK_FB_REG,
		S1_DIVCLK => CLK_DIV_REG(13 downto 0),
		S1_LOCK => CLK_FLTR_REG(7 downto 0) & CLK_LOCK_REG,
		S1_DIGITAL_FILT => CLK_FLTR_REG(25 downto 16),
		REF_CLK => REF_CLK_I,
		PXL_CLK => mmcm_clk,
		PXL_CLK1 => mmcm_clk1,
		CLKFBOUT_O => mmcm_fbclk_out,
		CLKFBOUT_I => mmcm_fbclk_in,
		LOCKED_O => aLocked
	);
	
	mmcm_fbclk_in <= mmcm_fbclk_out; --Don't bother compensating for any delay, because we don't need a phase relationship between
                           --REF_CLK and PXL_CLK
                           
SyncAsyncLocked: entity work.SyncAsync
   generic map (
      kResetTo => '0',
      kStages => 2, --use double FF synchronizer
      kResetPolarity => '0') 
   port map (
      aReset => s_axi_lite_aresetn,
      aIn => aLocked,
      OutClk => s_axi_lite_aclk,
      oOut => xLocked);

LockedDetect: process(s_axi_lite_aclk)
begin
   if Rising_Edge(s_axi_lite_aclk) then
      xLocked_q <= xLocked & xLocked_q(1);
      xLckdFallingFlag <= xLocked_q(1) and not xLocked;
      xLckdRisingFlag <= not xLocked_q(1) and xLocked;
   end if;
end process LockedDetect;
      	
	-- the global pixel clock (2026-11-02); the BUFR output only drives the
	-- OSERDES CLKDIV
	BUFG_pxl : BUFG
	port map (
		O => pxl_clk_g,
		I => mmcm_clk1
	);
	PXL_CLK_O <= pxl_clk_g;
	PXL_CLK_DIV_O <= pxl_clk;
	LOCKED_O <= aLocked; --dcm_locked of processor system reset expects direct connection to MMCM_Locked
   
   process (s_axi_lite_aclk)
	begin
    	if (rising_edge(s_axi_lite_aclk)) then
    		if (s_axi_lite_aresetn = '0') then
    			clk_state <= RESET;
    		else	
    			case clk_state is 
    			when RESET =>
    				clk_state <= WAIT_LOCKED;
    			when WAIT_LOCKED =>  
					-- This state ensures that the initial SRDY pulse 
					-- doesnt interfere with the WAIT_SRDY state
    				if (xLocked = '1') then
    					clk_state <= WAIT_EN;
    				end if;
    			when WAIT_EN =>
    				if (CTRL_REG(0) = '1') then
    					clk_state <= WAIT_SRDY;
    				end if;
    			when WAIT_SRDY =>
    				if (srdy = '1') then 
    					clk_state <= ENABLED;
    				end if;
    			when ENABLED =>
    				if (CTRL_REG(0) = '0') then
    					clk_state <= WAIT_EN;
    				end if;
    			when others => --Never reached
    				clk_state <= RESET;
    			end case;
    		end if;
    	end if;
	end process;
	
	STAT_REG(0) <= '1' when clk_state = ENABLED else
					'0';
					
process (s_axi_lite_aclk)
begin
	if (rising_edge(s_axi_lite_aclk)) then
		if (s_axi_lite_aresetn = '0') then
			sen_reg <= '0';
		else
			if (clk_state = WAIT_EN and CTRL_REG(0) = '1') then
				sen_reg <= '1';
			else
				sen_reg <= '0';
			end if;
		end if;
	end if;
end process;
   
	-- User logic ends

end arch_imp;
