exitrip/DEBAZAROS/sw/debazd/lfo.c

/*
 * lfo.c - soft oscillators, wave shapers, step sequences, envelopes.
 *
 * 16 LFOs, evaluated once per frame (vsync) in debazd's main thread.
 * value = min + (max - min) * quantise(curve(shape(phase)))
 *
 * OSC (<n> = 0..15 or a pattern):
 *   /lfo/<n>/shape  sine|tri|saw|ramp|square|random|smooth|step|noise|audio
 *   /lfo/<n>/rate   f:Hz                 (cycles per second)
 *   /lfo/<n>/frames i:n                  one cycle per n frames (frame exact)
 *   /lfo/<n>/width  f:0..1               square duty, tri peak position
 *   /lfo/<n>/phase  f:0..1               phase offset
 *   /lfo/<n>/range  f:min f:max          output range (default 0 1)
 *   /lfo/<n>/min f, /lfo/<n>/max f       one end of the range alone
 *   /lfo/<n>/curve  f:k                  y = y^k (1 = linear) wave shaper
 *   /lfo/<n>/steps  i:n                  quantise to n levels (0 = off)
 *   /lfo/<n>/seq    f:v0 f:v1 ...        step values (shape step), as 0..1
 *   /lfo/<n>/mode   loop|once            once = one cycle, then hold the end
 *   /lfo/<n>/trigger                     restart from phase 0 (and turn on)
 *   /lfo/<n>/on     [i:0|1]              default 1
 *   /lfo/<n>/every  i:k                  apply the target only every k-th frame
 *                                        (throttle heavy targets: a full-frame
 *                                        fade costs 25-60 ms)
 *   /lfo/<n>/target s:"/field/path"      write the value to fields (pattern ok,
 *                                        int = raw, Hz fields take Hz)
 *   /lfo/<n>/target s:"/addr a b $0 $f1" send a message to debazd itself each
 *                                        frame; $k = int value of LFO k,
 *                                        $fk = float value of LFO k
 *   /lfo/<n>/target                      (no argument) no target
 *   /lfo/<n>/audio  s:feature            shape audio (2026-11-01): the value
 *                                        follows an audio feature of react.c
 *                                        (level peak bass low mid high air flux
 *                                        beat band0..band15; /audio/react/source)
 *   /lfo/<n>/gain   f:k                  feature x k before the clamp to 0..1
 *                                        (default 1). 0 = auto: the feature /
 *                                        its recent peak (the peak halves in
 *                                        10 s): loud or quiet material both
 *                                        use the whole range
 *   /lfo/<n>/attack f:s, /release f:s    envelope follower times (default
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
