exitrip/DEBAZAROS/(commit log)

2024-10-26 building with extBrd HDMI pinout... not having these sources tracked really effed up the other branches
    [Vivado_dump.txt]
2024-10-26 removed SDR circuits but kept audio i/o
2024-12-11 mixer signal chain does trash anymoregit status! also theres's feedback loop between hdmiAught y einz
2025-01-26 add r1 pcb
    [3xHDMI-B_Cu.gbr, 3xHDMI-B_Mask.gbr, 3xHDMI-B_Paste.gbr, 3xHDMI-B_SilkS.gbr, 3xHDMI-Edge_Cuts.gbr, 3xHDMI-F_Cu.gbr, 3xHDMI-F_Mask.gbr, 3xHDMI-F_Paste.gbr]
2025-01-26 update with 3x pcb pinout, but only 0 and 1 are enabled.... yet to re-wade into previously failed clock distro experiments
    [ebaz4205.xdc]
2025-02-23 Revert "tryna figure out this clk shit"
    This reverts commit ad6a9c738b1ba4c81765aa10b25effe9aea2352e.
    [ebaz4205.xdc, mmcme2_drp.v]
2025-02-23 fix hdmi1 clk pinout
    [ebaz4205.xdc]
2025-09-08 still no green on output1
    [3xHDMI.kicad_pcb]
2025-09-12 basic feed back loop works!!! not surprising its touchy... only usable with pixclk below 720p@30Hz / 35MHZ
2026-01-01 recovered a decent build... after braking trying out frame buffer read IP
2026-07-13 fix gain6 vs out7 in mixer
    [mixer_v1_0.v]
2026-08-24 GOT INPUT WORKING ALRIGHTgit statusgit status
    [3xHDMI-openEMS-TopyIn1-simple.FCStd, 3xHDMI.kicad_sch, Vivado_dump.txt, air_gen_model.stl, fr4_gen_model.stl]
2026-09-26 prep array board
    [3xHDMI.kicad_pcb, 3xHDMI.kicad_sch]
2026-09-26 add messy graphics
    [3xHDMI.kicad_pcb]
2026-09-28 Update stack up and some other clean up
    [3xHDMI.kicad_pcb, 3xHDMI.kicad_sch]
2026-10-24 sw: debazd daemon, libdz, display strobe/LFO/sprites/text/transforms; 96 MB DTB
    Control plane (sw/, plain make with the Vitis gcc, no Vitis project):
    - debazd: OSC/UDP hardware daemon. 138 register fields traced from the BD
    (RBG lane order, DDS bit-31 enable), display routing, capture status,
    /subscribe events, button bindings (/io/press|release), drawing.
    - disp.c: real-time vsync thread (VTC ISR bit 13, 60.03 Hz, <0.1 ms jitter);
    frame-exact show/blank/seq on 12 slots (slot 11 = black). Verified per
    frame: 30 Hz strobe and a 5-slot 60 fps flipbook.
    - lfo.c: 16 LFOs / wave shapers / step sequences / envelopes; targets are
    fields or OSC message templates ($k = LFO values), with an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
2026-10-25 PetaLinux: import Tcl-built XSA, one base dtsi without PL nodes
    - hw-description: artifacts/ebaz4205_2out1in_20261025.xsa (hardware-tested);
    the new FSBL sets FCLK3 = 200 MHz (old one: 25 MHz)
    - system-user.dtsi rewritten from the values running on the bench board:
    96 MB reservation, one simplefb 1280x2160, fpga-full region; cma=256M
    dropped (kernel already refused it); root and .old copies removed
    - config: REMOVE_PL_DTB=y (generated PL nodes bound xilinx-vdma/xilinx-vtc
    and stale SDR-era nodes); hostname debaz4205; FPGA_MANAGER stays off so
    BOOT.BIN keeps the default bitstream (ethernet PHY clock comes from PL)
    - kernel: debugfs fragment from the Aug 2026 build machine changes
    -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
2026-10-25 PetaLinux: scrub SDR packages, add ffmpeg/exFAT/NAND, deploy plan
    - rootfs: remove Qt5/PyQt5, matplotlib, pip, audio, python-modules groups,
    buildessential + self-hosted, gdb, and the SDR recipes (myjtdx, fftw,
    chown-ebaz-uio-sdr-app, colorbars); add ffmpeg, parted, dosfstools,
    exfat-utils, rsync, ethtool, iproute2, curl, python3, htop, e2fsprogs
    - accept LICENSE_FLAGS commercial (ffmpeg)
    - kernel: exFAT (media partition), UBI/UBIFS (old NAND file system)
    - dtsi: enable the soldered NAND (smcc/nfc0) - read-only use
    - ROADMAP section 10: SD card image, partitions, deploy, read-only root
2026-10-26 ROADMAP: analysis - audio, PL_KEY I/O, fan ports, PL resources, 1080p; PS buttons/reset notes
2026-10-27 HDMI_0 hdmi_tx with its own audio + scheduler pipeline stage
2026-10-28 fan I/O, events, J3 hardware PWM, interconnect clean-up; pcmplay; bench tests
    Gateware (artifacts _fan, _ev, _pwm; _pwm partly tested on hardware 2026-10-28):
    - VDMA memory interconnects without data FIFO / register slice
    - fan connectors: J3/J5 pin 3 -> GPIO ch1 [15]/[16], pin 4 from IO_OUT
    (level, vsync); J3 hardware PWM (0x90-0x98, vsync lock); LED_RED port
    - event block on page 0x43C6_1000 (edges, 100 MHz timestamps, DDS phase at
    vsync, own IRQ on HDMI_0/In5)
    - build.tcl: phys_opt + post-route phys_opt (FCLK2 failed once without)
    Software:
    - debazd: fan PWM (hardware on J3, RT thread otherwise), /ev and /fan
    fields, vsync by VTC interrupt when a UIO node exists, field RMW lock
    - d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
2026-10-28 new gateware checks out except for fan connectors, buttons 5+6, and comm peripherals
2026-10-28 footprints, 1080p geometry, crops, capture follows input; EDID modes; bench results
    Gateware (artifacts p148 / rx2 / edid; tested on the board 2026-10-28):
    - event bits [13:9]: vid_out locked/underflow x2, dynclk lock; TS_VIDEO,
    underflow counters; hdmi_rx input size (RX_SIZE_H/V)
    - hdmi_rx finds islands by their guard band when the preamble is missed
    - pixel clock constrained for 148.5 MHz (1080p60: out of spec, the OSERDES
    limit is 600 MHz serial = 120 MHz pixel); hdmi_tx scheduler pipelined
    - EDID: + 1600x1200@30 (does not decode yet), 1280x960@60 (works)
    - run-time geometry from the display VDMA, fixed 7680-byte line pitch
    everywhere; /disp/<d>/crop; capture size follows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
2026-10-28 frame-synced display VDMAs + display interconnect FIFOs back (build fs)
    - hw/rtl/fsync_gen.v: VTC vsync -> FCLK2 one-clock pulse -> mm2s_fsync of
    both display VDMAs (c_use_mm2s_fsync = 1): address/crop changes take
    effect at a frame start instead of cutting a frame
    - display interconnects: 512-deep packet data FIFO + register slice again
    (without them a stalled output wedged the HP AFI read FIFO)
    - pixel clock timed for 108 MHz (1080p60 selectable but untimed)
    Tested on the board: moving crops at 60 changes/s -> 0 lock losses, 0
    underflows; hdmi2 restarts recover; live-input quarters work.
2026-10-28 1600x1200@30 CVT-RB capture EDID (build edid2); one capture owner; 800x600 clock
    - EDID: the extension DTDs are exactly the edid_add_dtd.py MODES. 1600x1200@30
    is now CVT reduced blanking (64.25 MHz) and decodes clean; + 1600x1200@25.
    dvi2rgb rev 15. Artifacts _edid2 (on the board).
    - hdmi2 leaves the capture alone while debazd runs (two owners wedged the
    HP1 AFI twice); plreload stops debazd before its capture soft reset,
    refuses to load when the reset sticks, and passes hdmi2 options.
    - debazd: waits for a slow capture soft reset instead of ending the watch;
    survives a SIGBUS during a pixel clock switch (retry after 1 ms).
    - hdmi2 800x600: dynclk VCO 1000 MHz (was 600 = the minim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
2026-10-28 movie + audio playback tools; PetaLinux: full userland, passwordless sudo
    - sw/tools/mkmovie.sh (host): any video -> 1280x720 MPEG-4, max 25 fps
    (the board plays 720p at ~26 fps; 30 fps breaks up the audio), PCM
    S16LE 48 kHz stereo, .mkv; -f fill, -t, -n, -u upload.
    - sw/tools/avplay.sh (board): one ffmpeg -> video to fbfeed, audio to
    pcmplay on the same output; -l loop, -k stop. Tested: 25.0 fps, 15
    underrun periods (start-up) per 60 s, with live capture on display 1.
    - CLAUDE.md: PCB connector names = BD names (HDMI0 = TMDS_*_0 = HDMI_0
    ...), no swap; the old "labels swapped" notes were wrong.
    - PetaLinux: procps, coreutils, util-linux, findutils, grep, sed, gawk,
    tar, less, fi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
2026-10-28 ALSA card DEBAZ: debaz-audio driver, DT node, alsa-utils; A/V routing test
    - PetaLinux recipe debaz-audio (out-of-tree platform driver, autoload):
    PCM 0 HDMI 0, 1 HDMI 1, 2 HDMI 2 In (capture), 3 I2S; S16_LE 2 ch 48 kHz;
    PIO refill from the FIFO level interrupt (GIC SPI 36); route controls
    Auto/Linux/Other. Tested on the board with hw/dt/debaz-audio.dtso +
    insmod: file playback 0 underruns, capture exact, drain on time.
    - system-user.dtsi: the audio@43c60000 node; rootfs: debaz-audio,
    alsa-utils (aplay, amixer, alsamixer, alsactl, speaker-test, alsaloop).
    - plreload.sh: refuses while a DEBAZ PCM is open; unbinds the driver
    around the PL load.
    - pcmplay -s 0,1 (same samples into s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
2026-10-28 alsa driver and set mac at first boot
2026-10-29 FM DDS for the wingit statusgit status
2026-11-01 added step files to board and began drafting mechanics
2026-11-01 tons of testing and new features, cueing system, video wall testing, ffmpeg and custom filters
2026-11-02 image sequences, paint tools, audio scope FFT source and skew
    - debazd anim.c: JPEG/PNG flipbook player (ring slots, vsync flips, both
    displays), save frame with quality + size, undo, timing sheet, onion
    skin, folder delete; lib/dz_img (TurboJPEG/libpng via dlopen)
    - web: Paint tab live/batch with undo, colour picker, brush menus, paint
    bucket (/draw/<s>/flood), save card, sequence player and folder upload
    - mkmedia -A: image sequences from folders, files and movie frames
    - dds.c scope: sources fft / fftlin (L, R, sum), mode free, skew, seam,
    trigger, smooth, table readback; react_spectrum per channel
    - debaz-sw recipe, docs (ROADMAP section 16, sw/README, CLAUDE.md)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
2026-11-02 signed mixer gains, build speed-ups, frame-rate measurement fix
    Gateware (mixer coreRevision 25, ROADMAP section 17, task 19):
    - mode 1 with signed operands: CTRL_1 [3] DIFF (A - B), [4] CENTRE (-128),
    [5] DSIGN (signed DDS); shared input registers -> one combinational
    5-DSP48 group (mixer_mac5) -> register, latency 3 px; still untimed
    - mode 5: signed constant from GAIN_chan_0 [23:0]
    - GAIN [31:24] not stored (reads 0, -360 FF); CTRL keeps 32 bits
    - tested on the board as artifacts/ebaz4205_2out1in_20261102_smix
    Build: IP cache (~/dz-ipcache), launch_runs jobs = cores - 4,
    hw/remote_build.sh for a parallel build on the build machine.
    Software: DZ_Q16S field unit, /mixer/<c>/g/<n>, dif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
2026-11-02 global pixel clock: MMCM CLKOUT1 on a BUFG, OSERDES behind a FIFO
    ROADMAP section 17 (branch signed-mixer), task 20:
    - axi_dynclk revision 3: CLKOUT1 (5 x CLKOUT0's divide) -> BUFG =
    PXL_CLK_O for all fabric logic; CLKOUT1 in the DRP table, register
    CLK_O1 at +0x24; BUFIO + BUFR only for the OSERDES (PXL_CLK_DIV_O);
    generic kSerialBufg (BUFG + BUFG, off: keeps 108 MHz in spec)
    - hdmi_tx: SerdesDivClk + hdmi_tx_cdc.v (the BUFR phase is one of 5);
    sims 15 x ALL PASS
    - BD Tcl: SerdesDivClk nets; XDC: dynclk_pxl clock, FIFO crossing
    - hdmi2 dynclk.c writes CLKOUT1
    - mixer GAIN [31:24] not stored (revision 24) to make it fit
    - tested on the board as artifacts/ebaz4205_2out1in_20261102_gpc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
2026-11-02 dsp-pipe on the board: results, decisions, HDMI_0 sync delay 4
    - artifacts/ebaz4205_2out1in_20261102_dsp (all timing met; tested: all 9
    modes, capture, mode 1 DIFF, signed hue)
    - dzsetup.sh: HDMI_0 sync delay 4 (pix_out 4 px later since rev 26)
    - ROADMAP section 17 (cherry-picked from capture-reset + results):
    capture-reset PAUSED, word-only writes not to be tried again (user)
    - CLAUDE.md: main line dsp-pipe, how to avoid the capture wedge
2026-11-02 ascii into a slot with alpha: NEON span blend, rest after slow frames; "slot alpha" label
    With /draw/<slot>/alpha below 1 the ASCII run blends a whole frame; a
    dz_surf_put call per pixel took 229 ms per frame (debazd blocked OSC).
    dz_surf_put_span blends the span in one pass (NEON, bit-exact with mix()
    for alpha 2..255, tested on the board): 60 ms. An ASCII run now rests as
    long as its last frame took, so it uses at most about half of the main
    loop. Web: the brush "opacity" is the slot alpha; labelled so.
